DL7AD/pecanpico10/decoder/html/power.png

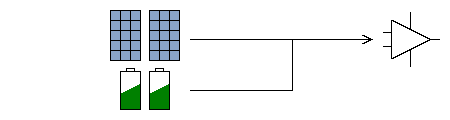
decoder/html/power.png
