DL7AD/pecanpico10/tracker/hardware/10a/output/pecanpico10_front.png

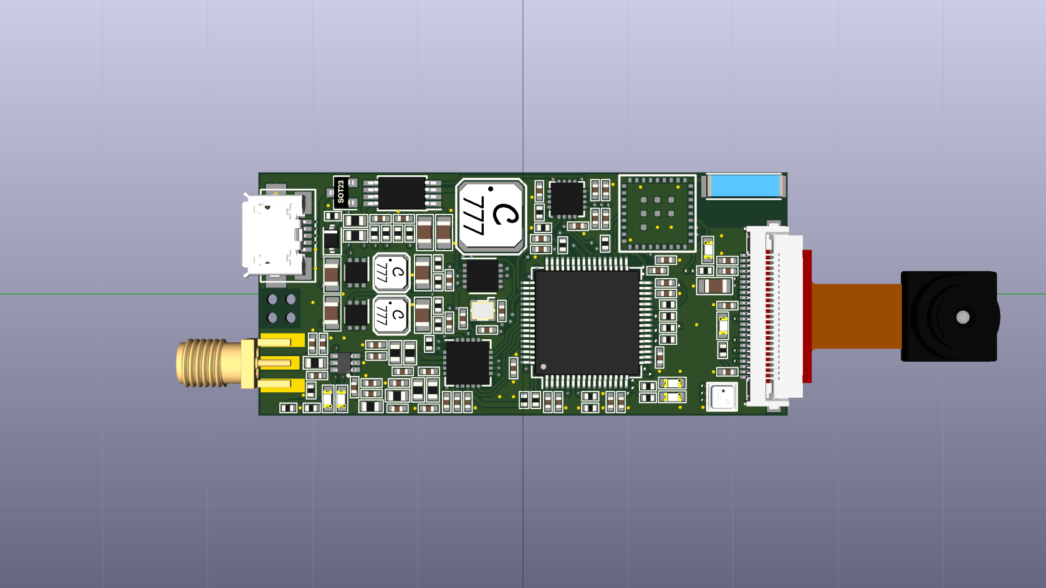
tracker/hardware/10a/output/pecanpico10_front.png
