DL7AD/pecanpico10/(threads)

Thread 3 (2018-08-04):

How to connect a camera?

df8oe, 2018-08-04:
I have bought OV5640 camera module whichuses 24p flatribbon connector. This seems to be a "standard" connector - many other camera modules do have this, too. But pinout is complete different to fpc used on Pecanpico... you can look for examples here:
[camera modules](https://www.alibaba.com/showroom/24-pin-hd-mini-camera-module.html)

Please can you point me how to adapt these modules to Pecanpico?

73
DF8OE
Andreas

Closed 2018-08-13.

Thread 5 (2018-11-06):

pecanpico10

SwiftFlying, 2018-11-06:
Hi,
PECANPICO10, will there be any image transmission error?

DL7AD, 2018-11-07:
Hi,

If you try to transmit an image without a camera attached to the Pecan itself, it will transmit an error picture instead.

Sven

SwiftFlying, 2018-11-07:
Hi,
https://github.com/TomasTT7/LoRa_SSDV
I'm testing LoRa_SSDV, Images transmitted are prone to errors. The author says there's something wrong with the camera power.I'm trying to solve this problem.And plans to build a relay device.

Tom

DL7AD, 2018-11-07:
Hi,

I have to admit that the SSDV algorithm is slightly modified from the original one because a APRS packet can't handle such long packets and overall also no binary data. The SyncByte, FEC and CRC is also not transmitted in the APRS packet because there is no need for it inside the APRS packet.

I shorten the SSDV packet by adding a new type
`#define SSDV_PKT_SIZE_PADDING (0x48)`

That option prevents the SSDV algorithm by putting so many bytes the packet. The additional data is simply put in the next packet. If you try to decode it with the very original SSDV code, you get an offset of the data.

While APRS can't handle binary data, we encode everything in base91 on top of it.

Sven

Closed 2019-02-05.
