DL7AD/pecanpico10/tracker/hardware/10b/output/pecanpico10.pdf

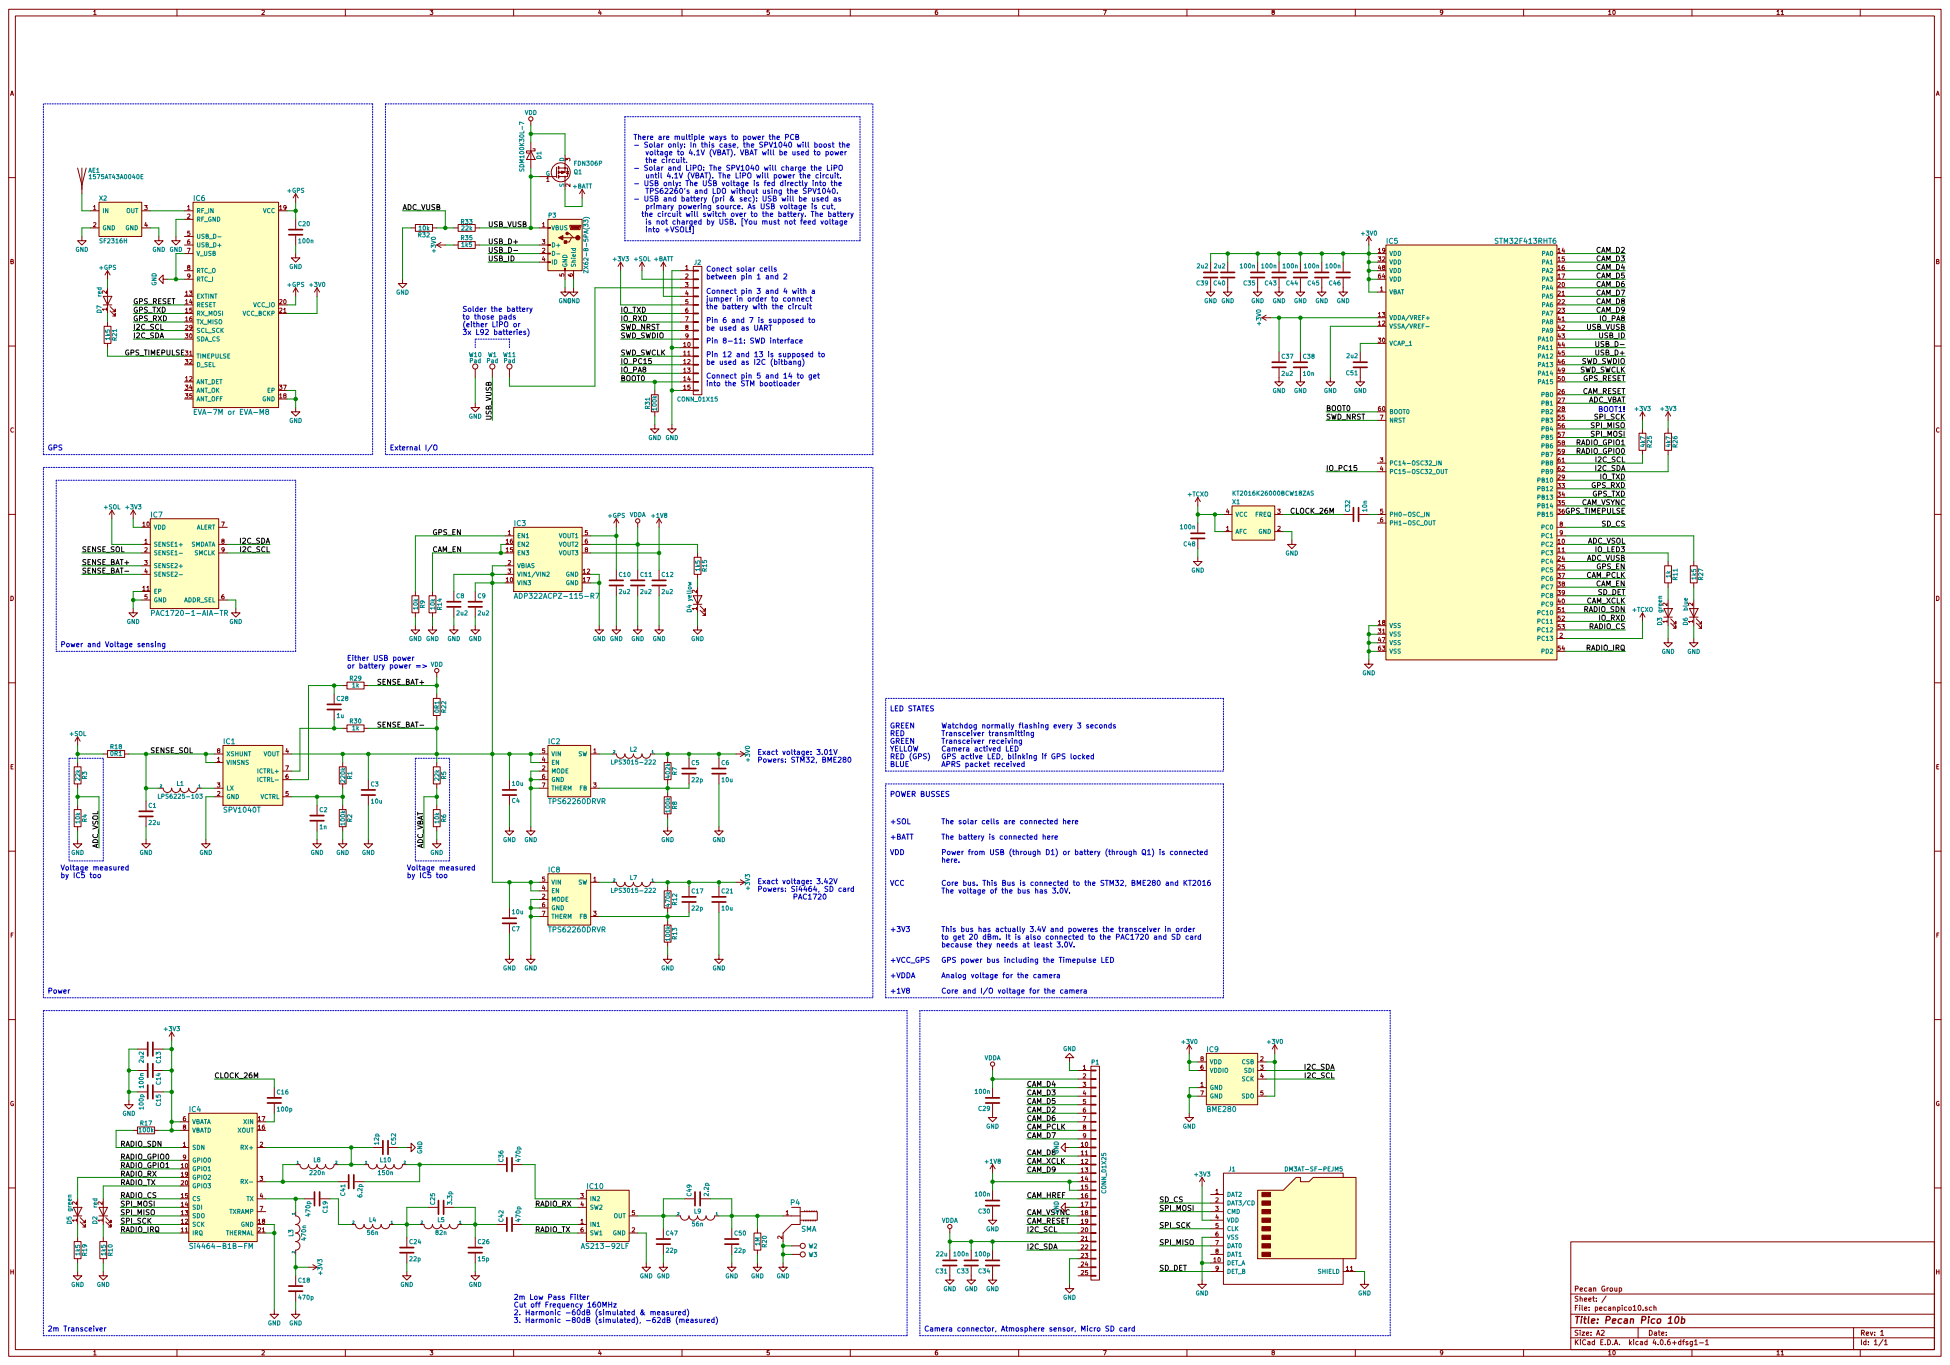
[picture p26: page 1]

There are multiple ways to power the PCB
- Solar only: In this case, the SPV1040 will boost the
voltage to 4.1V (VBAT). VBAT will be used to power
the circuit. - Solar and LiPO: The SPV1040 will charge the LiPO
until 4.1V (VBAT). The LiPO will power the circuit.
- USB only: The USB voltage is fed directly into the
TPS62260's and LDO without using the SPV1040.
- USB and battery (pri & sec): USB will be used as
primary powering source. As USB voltage is cut,
the circuit will switch over to the battery. The battery
is not charged by USB. [You must not feed voltage

+BATT Solder the battery

Conect solar cells
between pin 1 and 2
Connect pin 3 and 4 with a
jumper in order to connect
the battery with the circuit
Pin 6 and 7 is supposed to
be used as UART Pin 8-11: SWD interface
Pin 12 and 13 is supposed to
be used as I2C (bitbang)
Connect pin 5 and 14 to get
into the STM bootloader

Power and Voltage sensing

Transceiver transmitting
Transceiver receiving
Camera actived LED
GPS active LED, blinking if GPS locked
APRS packet received

Power from USB (through D1) or battery (through Q1) is connected
here. Core bus. This Bus is connected to the STM32, BME280 and KT2016

The voltage of the bus has 3.0V.

This bus has actually 3.4V and poweres the transceiver in order
to get 20 dBm. It is also connected to the PAC1720 and SD card
because they needs at least 3.0V.
GPS power bus including the Timepulse LED
Analog voltage for the camera
Core and I/O voltage for the camera
19 P1 CONN_01X25 GND GND GND

File: pecanpico10.sch Sheet: / Pecan Group

2m Low Pass Filter Cut off Frequency 160MHz
2. Harmonic -60dB (simulated & measured)
3. Harmonic -80dB (simulated), -62dB (measured)

Id: 1/1 Title: Pecan Pico 10b
