DL7AD/pecanpico10/tracker/hardware/10a/output/pecanpico10.pdf

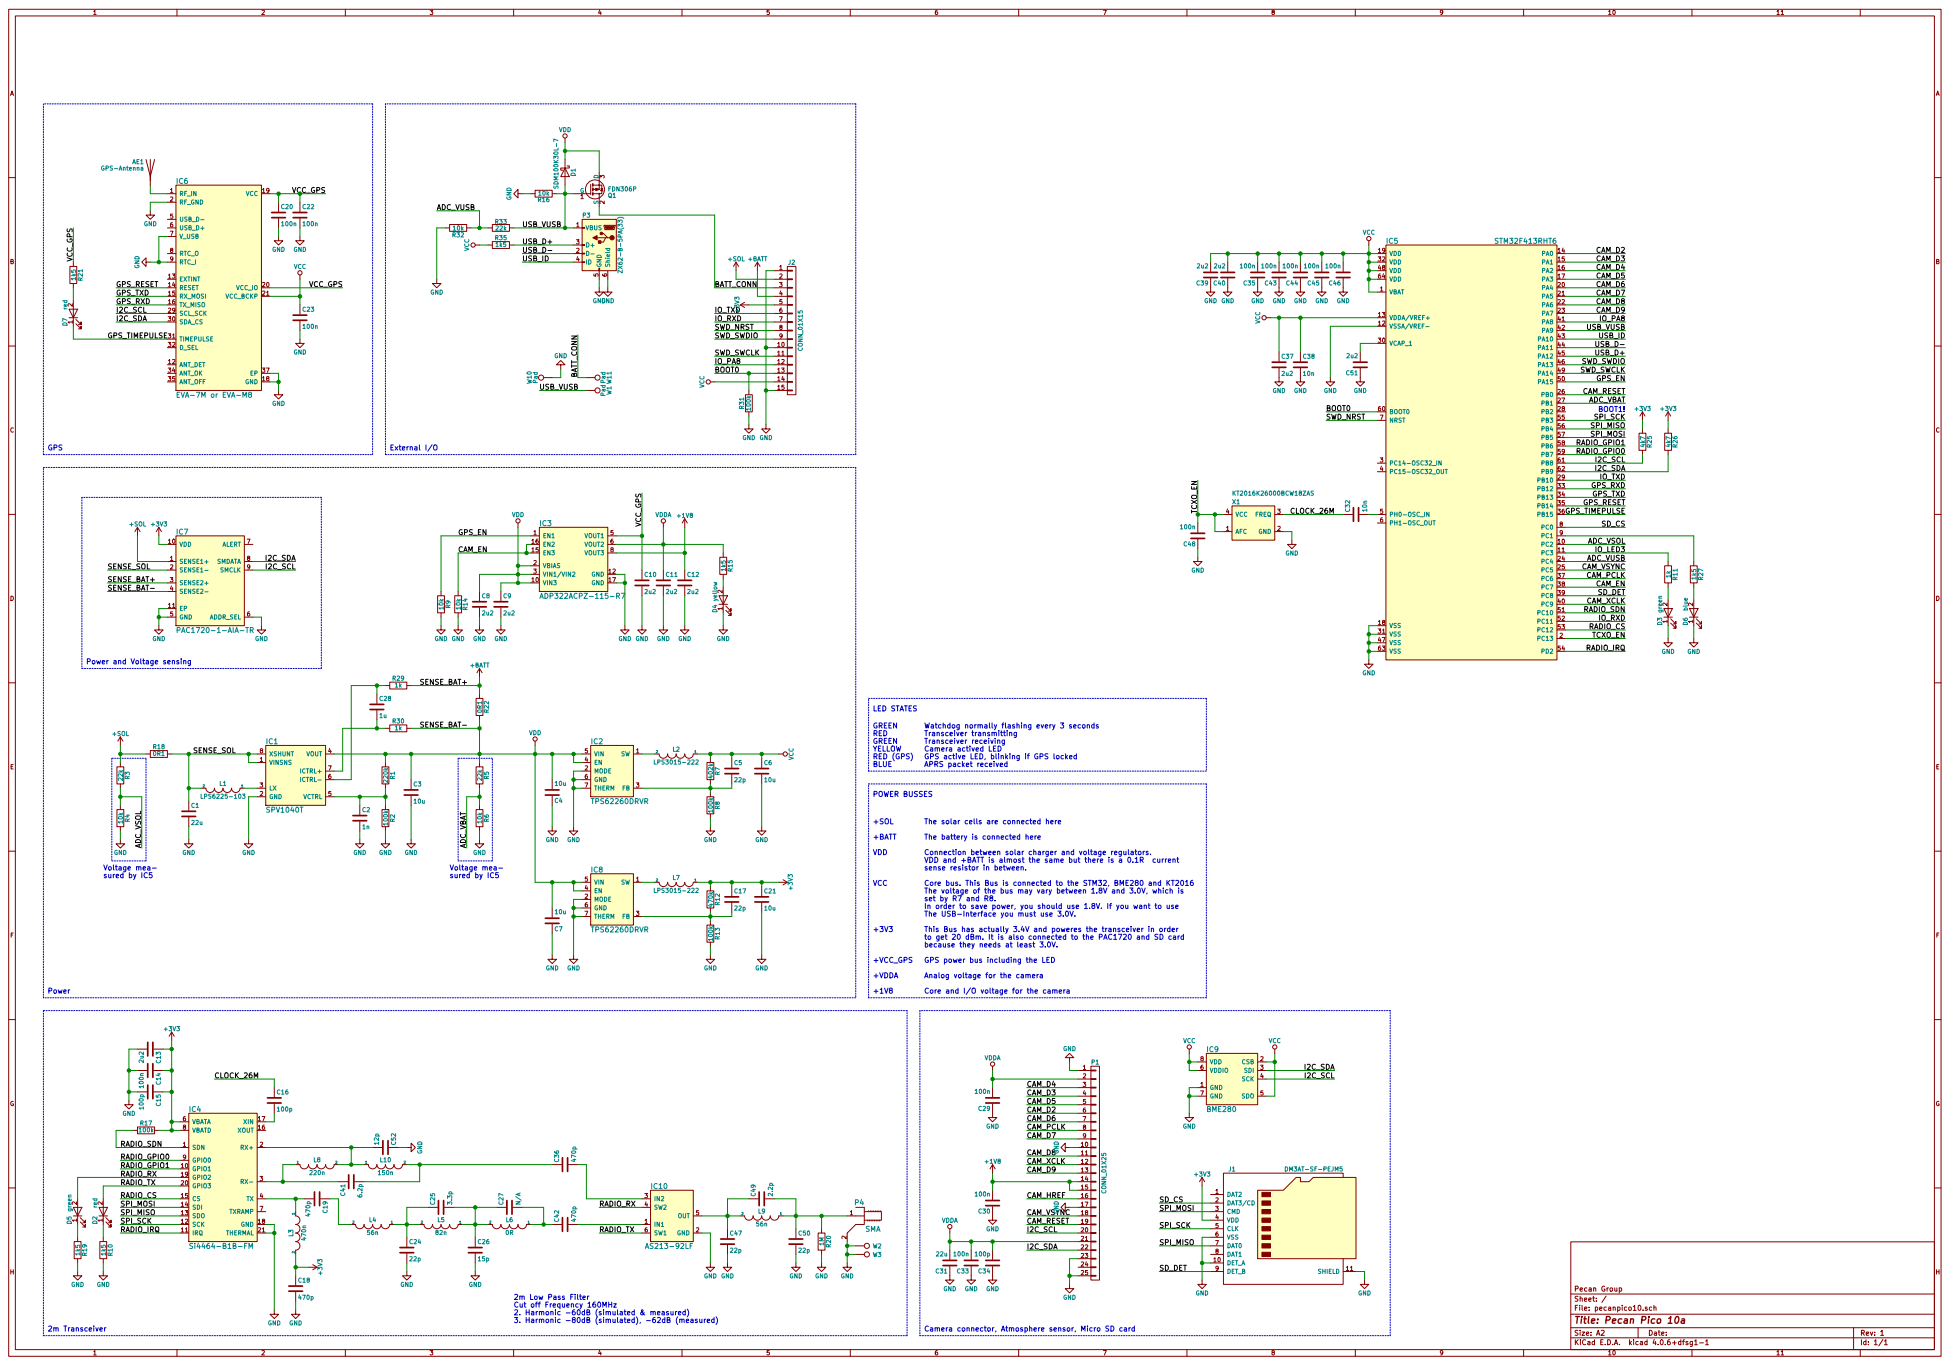
[picture p27: page 1]

27 PC6 | I2C_SCL

SPI_MISO
SPI_MOSI
RADIO_GPIO1

Power and Voltage sensing

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

Connection between solar charger and voltage regulators. VDD and +BATT is almost the same but there is a 0.1R current sense resistor in between. Core bus. This Bus is connected to the STM32, BME280 and KT2016

The voltage of the bus may vary between 1.8V and 3.0V, which is
set by R7 and R8.
In order to save power, you should use 1.8V. If you want to use
The USB-Interface you must use 3.0V.
This Bus has actually 3.4V and poweres the transceiver in order
to get 20 dBm. It is also connected to the PAC1720 and SD card
because they needs at least 3.0V.
GPS power bus including the LED
Analog voltage for the camera
Core and I/O voltage for the camera
19 P1 CONN_01X25 GND GND GND

File: pecanpico10.sch Sheet: / Pecan Group

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

Id: 1/1 Title: Pecan Pico 10a
