DL7AD/pecanpico10/tracker/hardware/10b/pecanpico10.kicad_pcb

## KiCad design tracker/hardware/10b/pecanpico10.kicad_pcb (2018-05-13)

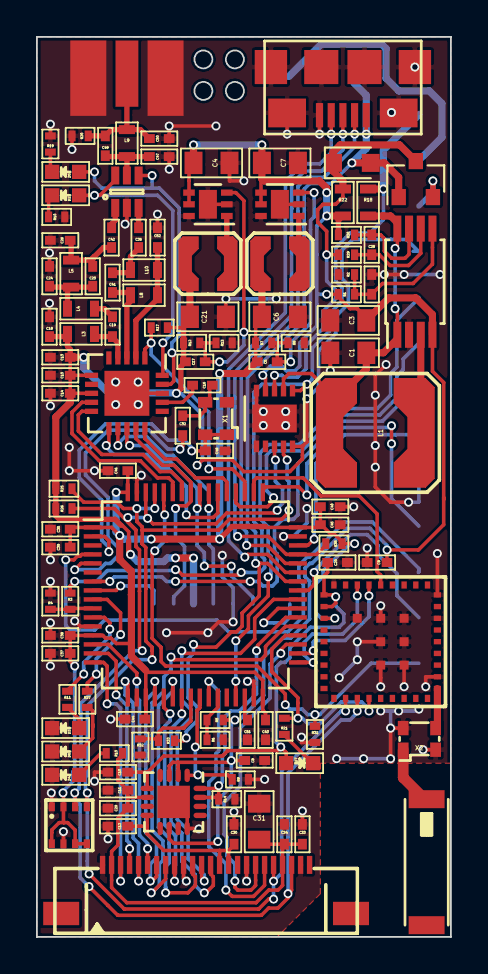
[picture p28: board pecanpico10.kicad_pcb from above]

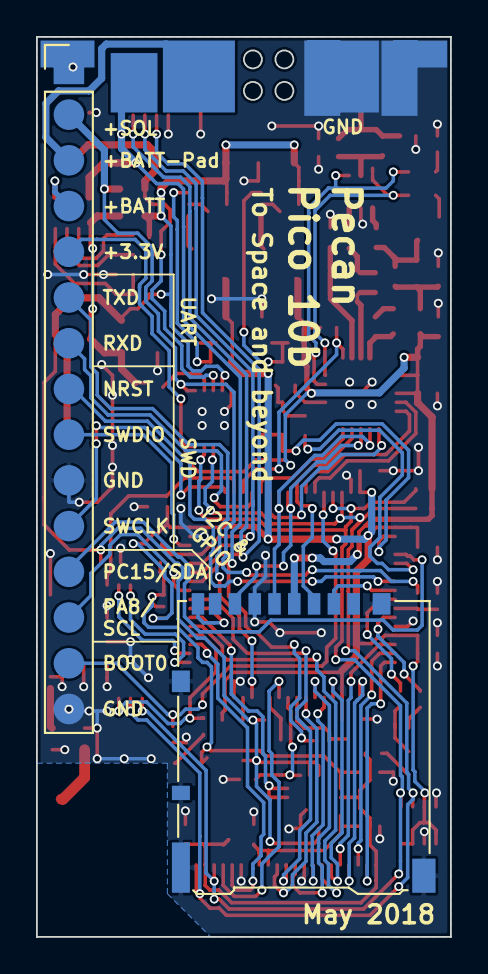
[picture p29: board pecanpico10.kicad_pcb from below]

Board: 2 copper layers, 23.0 x 50.0 mm, 119 parts (7 on the bottom side), 93 nets.

Parts:
AE1: 1575AT43A0040E; 575AT43A40
C1, C31: 22u; C_0805
C2: 1n; C_0402
C3, C4, C6, C7, C21: 10u; C_0805
C5, C17, C24, C47, C50: 22p; C_0402
C8, C9, C10, C11, C12, C13, C37, C39, C40, C51: 2u2; C_0402
C14, C20, C29, C30, C33, C35, C43, C44, C45, C46, C48: 100n; C_0402
C15, C16, C34: 100p; C_0402
C18, C19, C36, C42: 470p; C_0402
C25: 3.3p; C_0402
C26: 15p; C_0402
C28: 1u; C_0402
C32, C38: 10n; C_0402
C41: 6.2p; C_0402
C49: 2.2p; C_0402
C52: 12p; C_0402
D1: SDM100K30L-7; D_SOD-323
D2, D7: red; LED_0603
D3, D5: green; LED_0603
D4: yellow; LED_0603
D6: blue; LED_0603
IC1: SPV1040T; TSSOP-8_4.4x3mm_Pitch0.65mm
IC2, IC8: TPS62260DRVR; DFN-6-1EP_2x2mm_Pitch0.65mm
IC3: ADP322ACPZ-115-R7; QFN-16-1EP_3x3mm_Pitch0.5mm
IC4: Si4464-B1B-FM; QFN-20-1EP_4x4mm_Pitch0.5mm
IC5: STM32F413RHT6; LQFP-64_10x10mm_Pitch0.5mm
IC6: EVA-7M or EVA-M8; EVA7M
IC7: PAC1720-1-AIA-TR; DFN-10-1EP_3x3mm_Pitch0.5mm
IC9: BME280
IC10: AS213-92LF; SC-70-6
J1: DM3AT-SF-PEJM5; Hirose_DM3AT-SF-PEJM5
J2: CONN_01X15; Pin_Header_Straight_1x15_Pitch2.54mm
L1: LPS6225-103; LPS6225
L2, L7: LPS3015-222; LPS3015
L3: 470n; R_0603
L4, L9: 56n; R_0603
L5: 82n; R_0603
L8: 220n; R_0603
L10: 150n; R_0603
P1: CONN_01X25; FFC1x24_0.5mm
P3: ZX62-B-5PA(33); USB_Micro-B_SMD
P4: SMA; SMA_EDGE
Q1: FDN306P; SOT-23
R1: 220k; R_0402
R2, R8, R13, R17, R31: 100k; R_0402
R3, R5, R33: 22k; R_0402
R4, R6, R9, R14, R32: 10k; R_0402
R7: 402k; R_0402
R10, R15, R19, R21, R27, R35: 1k5; R_0402
R11, R29, R30: 1k; R_0402
R12: 470k; R_0402
R18, R22: 0R1; R_0603
R20: 1M; R_0402
R25, R26: 4k7; R_0402
W1, W11: Pad; PAD_3x3
W2, W3: Testpad; PAD_3x1.5
W10: Pad; PAD_6x3
X1: KT2016K26000BCW18ZAS; tcxo
X2: SF2316H; tcxo

Connections:
+1V8: C12.1, C30.2, IC3.8, P1.14, P1.15
+3V0: C5.1, C6.1, C35.2, C37.1, C38.1, C39.2, C40.2, C43.2, C44.2, C45.2, C46.2, IC5.1, IC5.13, IC5.19, IC5.32, IC5.48, IC5.64, IC6.21, IC9.2, IC9.5, IC9.6, IC9.8, L2.1, R7.1, R35.1
+3V3: C13.1, C14.1, C15.1, C17.1, C18.1, C21.1, IC4.6, IC4.8, IC7.10, J1.4, J2.5, L3.2, L7.1, R12.1, R17.2, R25.1, R26.1
+BATT: J2.4, Q1.2
+GPS: C10.1, C20.1, D7.2, IC3.5, IC6.19, IC6.20
+SOL: IC7.1, J2.2, R3.1, R18.1
+TCXO: C48.2, IC5.2, X1.1, X1.4
/ADC_VBAT: IC5.27, R5.2, R6.1
/ADC_VSOL: IC5.10, R3.2, R4.1
/ADC_VUSB: IC5.24, R32.1, R33.2
/BOOT0: IC5.60, J2.14, R31.1
/CAM_D2: IC5.14, P1.6
/CAM_D3: IC5.15, P1.4
/CAM_D4: IC5.16, P1.3
/CAM_D5: IC5.17, P1.5
/CAM_D6: IC5.20, P1.7
/CAM_D7: IC5.21, P1.9
/CAM_D8: IC5.22, P1.11
/CAM_D9: IC5.23, P1.13
/CAM_EN: IC3.15, IC3.16, IC5.38, R14.1
/CAM_PCLK: IC5.37, P1.8
/CAM_RESET: IC5.26, P1.19
/CAM_VSYNC: IC5.35, P1.18
/CAM_XCLK: IC5.40, P1.12
/CLOCK_26M: C16.1, C32.1, X1.3
/GPS_EN: IC3.1, IC5.25, R9.1
/GPS_RESET: IC5.50, IC6.14
/GPS_RXD: IC5.33, IC6.16
/GPS_TIMEPULSE: IC5.36, IC6.31, R21.2
/GPS_TXD: IC5.34, IC6.15
/I2C_SCL: IC5.61, IC6.29, IC7.9, IC9.4, P1.20, R25.2
/I2C_SDA: IC5.62, IC6.30, IC7.8, IC9.3, P1.22, R26.2
/IO_LED3: IC5.11, R11.1
/IO_PA8: IC5.41, J2.13
/IO_PC15: IC5.4, J2.12
/IO_RXD: IC5.52, J2.7
/IO_TXD: IC5.29, J2.6
/RADIO_CS: IC4.15, IC5.53
/RADIO_GPIO0: IC4.9, IC5.59
/RADIO_GPIO1: IC4.10, IC5.58
/RADIO_IRQ: IC4.11, IC5.54
/RADIO_RX: D5.2, IC4.19, IC10.4
/RADIO_SDN: IC4.1, IC5.51, R17.1
/RADIO_TX: D2.2, IC4.20, IC10.6
/SD_CS: IC5.8, J1.2
/SD_DET: IC5.39, J1.9
/SENSE_BAT-: C3.1, C4.2, C7.2, C8.1, C9.1, IC1.4, IC2.4, IC2.5, IC3.2, IC3.3, IC3.10, IC7.4, IC8.4, IC8.5, R1.1, R5.1, R22.2, R30.2
/SENSE_SOL: C1.1, IC1.1, IC1.8, IC7.2, L1.2, R18.2
/SPI_MISO: IC4.13, IC5.56, J1.7
/SPI_MOSI: IC4.14, IC5.57, J1.3
/SPI_SCK: IC4.12, IC5.55, J1.5
/SWD_NRST: IC5.7, J2.8
/SWD_SWCLK: IC5.49, J2.11
/SWD_SWDIO: IC5.46, J2.9
/USB_D+: IC5.45, P3.3, R35.2
/USB_D-: IC5.44, P3.2
/USB_ID: IC5.43, P3.4
/USB_VUSB: D1.2, IC5.42, P3.1, Q1.1, R33.1, W1.1
GND: C1.2, C2.2, C3.2, C4.1, C6.2, C7.1, C8.2, C9.2, C10.2, C11.2, C12.2, C13.2, C14.2, C15.2, C18.2, C20.2, C21.2, C24.2, C26.2, C29.1, C30.1, C31.1, C33.1, C34.1, C35.1, C37.2, C38.2, C39.1, C40.1, C43.1, C44.1, C45.1, C46.1, C47.2, C48.1, C50.2, C51.1, C52.1, D3.1, D4.1, D6.1, IC1.2, IC2.2, IC2.6, IC2.7, IC3.12, IC3.17, IC4.18, IC4.21, IC5.12, IC5.18, IC5.31, IC5.47, IC5.63, IC6.2, IC6.7, IC6.9, IC6.18, IC6.37, IC7.5, IC7.6, IC7.11, IC8.2, IC8.6, IC8.7, IC9.1, IC9.7, IC10.2, J1.6, J1.10, J1.11, J2.1, J2.10, J2.15, P1.1, P1.10, P1.17, P1.23, P3.5, P3.6, P4.2, R2.2, R4.2, R6.2, R8.2, R9.2, R10.2, R13.2, R14.2, R19.2, R20.2, R31.2, R32.2, W2.1, W3.1, W10.1, X1.2, X2.2, X2.4
unnamed: AE1.1, X2.1
unnamed: C2.1, IC1.5, R1.2, R2.1
unnamed: C5.2, IC2.3, R7.2, R8.1
unnamed: C16.2, IC4.17
unnamed: C17.2, IC8.3, R12.2, R13.1
unnamed: C19.1, L4.2
unnamed: C19.2, IC4.4, L3.1
unnamed: C24.1, C25.1, L4.1, L5.2
unnamed: C25.2, C26.1, C42.1, L5.1
unnamed: C28.1, IC1.6, R29.1
unnamed: C28.2, IC1.7, R30.1
unnamed: C32.2, IC5.5
unnamed: C36.1, C41.2, L10.2
unnamed: C36.2, IC10.3
unnamed: C41.1, IC4.3, L8.1
unnamed: C42.2, IC10.1
unnamed: C47.1, C49.1, IC10.5, L9.2
unnamed: C49.2, C50.1, L9.1, P4.1, R20.1
unnamed: C51.2, IC5.30
unnamed: C52.2, IC4.2, L8.2, L10.1
unnamed: D2.1, R10.1
unnamed: D3.2, R11.2
unnamed: D4.2, R15.2
unnamed: D5.1, R19.1
unnamed: D6.2, R27.2
unnamed: D7.1, R21.1
unnamed: IC1.3, L1.1
unnamed: IC2.1, L2.2
unnamed: IC5.9, R27.1
unnamed: IC6.1, X2.3
unnamed: IC8.1, L7.2
unnamed: J2.3, W11.1
VDD: D1.1, IC7.3, Q1.3, R22.1, R29.2
VDDA: C11.1, C29.2, C31.2, C33.2, C34.2, IC3.6, P1.2, P1.21, R15.1
