DL7AD/pecanpico10/tracker/software/cfg/pp10a/board/board.h

/*
    ChibiOS - Copyright (C) 2006..2016 Giovanni Di Sirio

    Licensed under the Apache License, Version 2.0 (the "License");
    you may not use this file except in compliance with the License.
    You may obtain a copy of the License at

        http://www.apache.org/licenses/LICENSE-2.0

    Unless required by applicable law or agreed to in writing, software
    distributed under the License is distributed on an "AS IS" BASIS,
    WITHOUT WARRANTIES OR CONDITIONS OF ANY KIND, either express or implied.
    See the License for the specific language governing permissions and
    limitations under the License.
*/

#ifndef _BOARD_H_
#define _BOARD_H_

/*
 * Setup for Pecan Pico 10a board.
 */

/*
 * Board identifier.
 */
#define BOARD_PECANPICO10A
#define BOARD_NAME                  "Pecan Pico 10a"

/*
 * No LSE available
 */
#if !defined(STM32_LSECLK)
#define STM32_LSECLK                0U
#endif

#if !defined(STM32_HSECLK)
#define STM32_HSECLK                26000000U
#endif

/*
 * Board voltages
 * Required for performance limits calculation
 */
#define STM32_VDD                   180U

/*
 * MCU type as defined in the ST header
 */
#define STM32F413xx

/*
 * IO pins assignments.
 */
#define GPIOA_PIN0                  0U
#define GPIOA_PIN1                  1U
#define GPIOA_PIN2                  2U
#define GPIOA_PIN3                  3U
#define GPIOA_PIN4                  4U
#define GPIOA_PIN5                  5U
#define GPIOA_PIN6                  6U
#define GPIOA_PIN7                  7U
#define GPIOA_PIN8                  8U
#define GPIOA_USB_VBUS              9U
#define GPIOA_USB_ID                10U
#define GPIOA_USB_DM                11U
#define GPIOA_USB_DP                12U
#define GPIOA_SWDIO                 13U
#define GPIOA_SWCLK                 14U
#define GPIOA_PIN15                 15U

#define GPIOB_PIN0                  0U
#define GPIOB_PIN1                  1U
#define GPIOB_PIN2                  2U
#define GPIOB_PIN3                  3U
#define GPIOB_PIN4                  4U
#define GPIOB_PIN5                  5U
#define GPIOB_PIN6                  6U
#define GPIOB_PIN7                  7U
#define GPIOB_PIN8                  8U
#define GPIOB_PIN9                  9U
#define GPIOB_PIN10                 10U
#define GPIOB_PIN11                 11U
#define GPIOB_PIN12                 12U
#define GPIOB_PIN13                 13U
#define GPIOB_PIN14                 14U
#define GPIOB_PIN15                 15U

#define GPIOC_PIN0                  0U
#define GPIOC_PIN1                  1U
#define GPIOC_PIN2                  2U
#define GPIOC_PIN3                  3U
#define GPIOC_PIN4                  4U
#define GPIOC_PIN5                  5U
#define GPIOC_PIN6                  6U
#define GPIOC_PIN7                  7U
#define GPIOC_PIN8                  8U
#define GPIOC_PIN9                  9U
#define GPIOC_PIN10                 10U
#define GPIOC_PIN11                 11U
#define GPIOC_PIN12                 12U
#define GPIOC_PIN13                 13U
#define GPIOC_OSC32_IN              14U
#define GPIOC_OSC32_OUT             15U

#define GPIOD_PIN0                  0U
#define GPIOD_PIN1                  1U
#define GPIOD_PIN2                  2U
#define GPIOD_PIN3                  3U
#define GPIOD_PIN4                  4U
#define GPIOD_PIN5                  5U
#define GPIOD_PIN6                  6U
#define GPIOD_PIN7                  7U
#define GPIOD_PIN8                  8U
#define GPIOD_PIN9                  9U
#define GPIOD_PIN10                 10U
#define GPIOD_PIN11                 11U
#define GPIOD_PIN12                 12U
#define GPIOD_PIN13                 13U
#define GPIOD_PIN14                 14U
#define GPIOD_PIN15                 15U

#define GPIOE_PIN0                  0U
#define GPIOE_PIN1                  1U
#define GPIOE_PIN2                  2U
#define GPIOE_PIN3                  3U
#define GPIOE_PIN4                  4U
#define GPIOE_PIN5                  5U
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
#define GPIOJ_PIN9                  9U
#define GPIOJ_PIN10                 10U
#define GPIOJ_PIN11                 11U
#define GPIOJ_PIN12                 12U
#define GPIOJ_PIN13                 13U
#define GPIOJ_PIN14                 14U
#define GPIOJ_PIN15                 15U

#define GPIOK_PIN0                  0U
#define GPIOK_PIN1                  1U
#define GPIOK_PIN2                  2U
#define GPIOK_PIN3                  3U
#define GPIOK_PIN4                  4U
#define GPIOK_PIN5                  5U
#define GPIOK_PIN6                  6U
#define GPIOK_PIN7                  7U
#define GPIOK_PIN8                  8U
#define GPIOK_PIN9                  9U
#define GPIOK_PIN10                 10U
#define GPIOK_PIN11                 11U
#define GPIOK_PIN12                 12U
#define GPIOK_PIN13                 13U
#define GPIOK_PIN14                 14U
#define GPIOK_PIN15                 15U

/* For enabling TCXO. Done in early_init. */
#define LINE_TCXO_EN                PAL_LINE(GPIOC, 13U)

/*
 * I/O ports initial setup, this configuration is established soon after reset
 * in the initialization code.
 * Please refer to the STM32 Reference Manual for details.
 */
#define PIN_MODE_INPUT(n)           (0U << ((n) * 2U))
#define PIN_MODE_OUTPUT(n)          (1U << ((n) * 2U))
#define PIN_MODE_ALTERNATE(n)       (2U << ((n) * 2U))
#define PIN_MODE_ANALOG(n)          (3U << ((n) * 2U))
#define PIN_ODR_LOW(n)              (0U << (n))
#define PIN_ODR_HIGH(n)             (1U << (n))
#define PIN_OTYPE_PUSHPULL(n)       (0U << (n))
#define PIN_OTYPE_OPENDRAIN(n)      (1U << (n))
#define PIN_OSPEED_VERYLOW(n)       (0U << ((n) * 2U))
#define PIN_OSPEED_LOW(n)           (1U << ((n) * 2U))
#define PIN_OSPEED_MEDIUM(n)        (2U << ((n) * 2U))
#define PIN_OSPEED_HIGH(n)          (3U << ((n) * 2U))
#define PIN_PUPDR_FLOATING(n)       (0U << ((n) * 2U))
#define PIN_PUPDR_PULLUP(n)         (1U << ((n) * 2U))
#define PIN_PUPDR_PULLDOWN(n)       (2U << ((n) * 2U))
#define PIN_AFIO_AF(n, v)           ((v) << (((n) % 8U) * 4U))

/*
 * GPIOA setup:
 *
 * PA0  - CAM_D2                    (input pulldown).
 * PA1  - CAM_D3                    (input pulldown).
 * PA2  - CAM_D4                    (input pulldown).
 * PA3  - CAM_D5                    (input pulldown).
 * PA4  - CAM_D6                    (input pulldown).
 * PA5  - CAM_D7                    (input pulldown).
 * PA6  - CAM_D8                    (input pulldown).
 * PA7  - CAM_D9                    (input pulldown).
 * PA8  - IO_PA8                    (input floating).
 * PA9  - USB_VBUS                  (input floating).
 * PA10 - USB_ID                    (alternate 10).
 * PA11 - USB_DM                    (alternate 10).
 * PA12 - USB_DP                    (alternate 10).
 * PA13 - SWDIO                     (alternate 0).
 * PA14 - SWCLK                     (alternate 0).
 * PA15 - GPS_EN                    (input pulldown).
 */
#define VAL_GPIOA_MODER             (PIN_MODE_INPUT(GPIOA_PIN0) |           \
                                     PIN_MODE_INPUT(GPIOA_PIN1) |           \
                                     PIN_MODE_INPUT(GPIOA_PIN2) |           \
                                     PIN_MODE_INPUT(GPIOA_PIN3) |           \
                                     PIN_MODE_INPUT(GPIOA_PIN4) |           \
                                     PIN_MODE_INPUT(GPIOA_PIN5) |           \
                                     PIN_MODE_INPUT(GPIOA_PIN6) |           \
                                     PIN_MODE_INPUT(GPIOA_PIN7) |           \
                                     PIN_MODE_INPUT(GPIOA_PIN8) |           \
                                     PIN_MODE_INPUT(GPIOA_USB_VBUS) |       \
                                     PIN_MODE_ALTERNATE(GPIOA_USB_ID) |     \
                                     PIN_MODE_ALTERNATE(GPIOA_USB_DM) |     \
                                     PIN_MODE_ALTERNATE(GPIOA_USB_DP) |     \
                                     PIN_MODE_ALTERNATE(GPIOA_SWDIO) |      \
                                     PIN_MODE_ALTERNATE(GPIOA_SWCLK) |      \
                                     PIN_MODE_INPUT(GPIOA_PIN15))
#define VAL_GPIOA_OTYPER            (PIN_OTYPE_PUSHPULL(GPIOA_PIN0) |       \
                                     PIN_OTYPE_PUSHPULL(GPIOA_PIN1) |       \
                                     PIN_OTYPE_PUSHPULL(GPIOA_PIN2) |       \
                                     PIN_OTYPE_PUSHPULL(GPIOA_PIN3) |       \
                                     PIN_OTYPE_PUSHPULL(GPIOA_PIN4) |       \
                                     PIN_OTYPE_PUSHPULL(GPIOA_PIN5) |       \
                                     PIN_OTYPE_PUSHPULL(GPIOA_PIN6) |       \
                                     PIN_OTYPE_PUSHPULL(GPIOA_PIN7) |       \
                                     PIN_OTYPE_PUSHPULL(GPIOA_PIN8) |       \
                                     PIN_OTYPE_PUSHPULL(GPIOA_USB_VBUS) |   \
                                     PIN_OTYPE_PUSHPULL(GPIOA_USB_ID) |     \
                                     PIN_OTYPE_PUSHPULL(GPIOA_USB_DM) |     \
                                     PIN_OTYPE_PUSHPULL(GPIOA_USB_DP) |     \
                                     PIN_OTYPE_PUSHPULL(GPIOA_SWDIO) |      \
                                     PIN_OTYPE_PUSHPULL(GPIOA_SWCLK) |      \
                                     PIN_OTYPE_PUSHPULL(GPIOA_PIN15))
#define VAL_GPIOA_OSPEEDR           (PIN_OSPEED_VERYLOW(GPIOA_PIN0) |       \
                                     PIN_OSPEED_VERYLOW(GPIOA_PIN1) |       \
                                     PIN_OSPEED_VERYLOW(GPIOA_PIN2) |       \
                                     PIN_OSPEED_VERYLOW(GPIOA_PIN3) |       \
                                     PIN_OSPEED_VERYLOW(GPIOA_PIN4) |       \
                                     PIN_OSPEED_VERYLOW(GPIOA_PIN5) |       \
                                     PIN_OSPEED_VERYLOW(GPIOA_PIN6) |       \
                                     PIN_OSPEED_VERYLOW(GPIOA_PIN7) |       \
                                     PIN_OSPEED_VERYLOW(GPIOA_PIN8) |       \
                                     PIN_OSPEED_HIGH(GPIOA_USB_VBUS) |      \
                                     PIN_OSPEED_HIGH(GPIOA_USB_ID) |        \
                                     PIN_OSPEED_HIGH(GPIOA_USB_DM) |        \
                                     PIN_OSPEED_HIGH(GPIOA_USB_DP) |        \
                                     PIN_OSPEED_HIGH(GPIOA_SWDIO) |         \
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
                                     PIN_AFIO_AF(GPIOA_SWDIO, 0) |          \
                                     PIN_AFIO_AF(GPIOA_SWCLK, 0) |          \
                                     PIN_AFIO_AF(GPIOA_PIN15, 0))

/*
 * GPIOB setup:
 *
 * PB0  - CAM_RESET                 (input pulldown).
 * PB1  - ADC_VBAT                  (input pulldown).
 * PB2  - BOOT1                     (input pulldown).
 * PB3  - SPI_SCK                   (input pulldown).
 * PB4  - SPI_MISO                  (input pulldown).
 * PB5  - SPI_MOSI                  (input pulldown).
 * PB6  - RADIO_GPIO1               (input pulldown).
 * PB7  - RADIO_GPIO0               (input pulldown).
 * PB8  - I2C_SCL                   (input pulldown).
 * PB9  - I2C_SDA                   (input pulldown).
 * PB10 - IO_TXD                    (input floating).
 * PB11 - PIN11                     (input pulldown).
 * PB12 - GPS_RXD                   (input pulldown).
 * PB13 - GPS_TXD                   (input pulldown).
 * PB14 - GPS_RESET                 (input pulldown).
 * PB15 - GPS_TIMEPULSE             (input pulldown).
 */
#define VAL_GPIOB_MODER             (PIN_MODE_INPUT(GPIOB_PIN0) |           \
                                     PIN_MODE_INPUT(GPIOB_PIN1) |           \
                                     PIN_MODE_INPUT(GPIOB_PIN2) |           \
                                     PIN_MODE_INPUT(GPIOB_PIN3) |           \
                                     PIN_MODE_INPUT(GPIOB_PIN4) |           \
                                     PIN_MODE_INPUT(GPIOB_PIN5) |           \
                                     PIN_MODE_INPUT(GPIOB_PIN6) |           \
                                     PIN_MODE_INPUT(GPIOB_PIN7) |           \
                                     PIN_MODE_INPUT(GPIOB_PIN8) |           \
                                     PIN_MODE_INPUT(GPIOB_PIN9) |           \
                                     PIN_MODE_INPUT(GPIOB_PIN10) |          \
                                     PIN_MODE_INPUT(GPIOB_PIN11) |          \
                                     PIN_MODE_INPUT(GPIOB_PIN12) |          \
                                     PIN_MODE_INPUT(GPIOB_PIN13) |          \
                                     PIN_MODE_INPUT(GPIOB_PIN14) |          \
                                     PIN_MODE_INPUT(GPIOB_PIN15))
#define VAL_GPIOB_OTYPER            (PIN_OTYPE_PUSHPULL(GPIOB_PIN0) |       \
                                     PIN_OTYPE_PUSHPULL(GPIOB_PIN1) |       \
                                     PIN_OTYPE_PUSHPULL(GPIOB_PIN2) |       \
                                     PIN_OTYPE_PUSHPULL(GPIOB_PIN3) |       \
                                     PIN_OTYPE_PUSHPULL(GPIOB_PIN4) |       \
                                     PIN_OTYPE_PUSHPULL(GPIOB_PIN5) |       \
                                     PIN_OTYPE_PUSHPULL(GPIOB_PIN6) |       \
                                     PIN_OTYPE_PUSHPULL(GPIOB_PIN7) |       \
                                     PIN_OTYPE_PUSHPULL(GPIOB_PIN8) |       \
                                     PIN_OTYPE_PUSHPULL(GPIOB_PIN9) |       \
                                     PIN_OTYPE_PUSHPULL(GPIOB_PIN10) |      \
                                     PIN_OTYPE_PUSHPULL(GPIOB_PIN11) |      \
                                     PIN_OTYPE_PUSHPULL(GPIOB_PIN12) |      \
                                     PIN_OTYPE_PUSHPULL(GPIOB_PIN13) |      \
                                     PIN_OTYPE_PUSHPULL(GPIOB_PIN14) |      \
                                     PIN_OTYPE_PUSHPULL(GPIOB_PIN15))
#define VAL_GPIOB_OSPEEDR           (PIN_OSPEED_VERYLOW(GPIOB_PIN0) |       \
                                     PIN_OSPEED_VERYLOW(GPIOB_PIN1) |       \
                                     PIN_OSPEED_VERYLOW(GPIOB_PIN2) |       \
                                     PIN_OSPEED_HIGH(GPIOB_PIN3) |          \
                                     PIN_OSPEED_HIGH(GPIOB_PIN4) |          \
                                     PIN_OSPEED_HIGH(GPIOB_PIN5) |          \
                                     PIN_OSPEED_VERYLOW(GPIOB_PIN6) |       \
                                     PIN_OSPEED_VERYLOW(GPIOB_PIN7) |       \
                                     PIN_OSPEED_VERYLOW(GPIOB_PIN8) |       \
                                     PIN_OSPEED_VERYLOW(GPIOB_PIN9) |       \
                                     PIN_OSPEED_VERYLOW(GPIOB_PIN10) |      \
                                     PIN_OSPEED_VERYLOW(GPIOB_PIN11) |      \
                                     PIN_OSPEED_VERYLOW(GPIOB_PIN12) |      \
                                     PIN_OSPEED_VERYLOW(GPIOB_PIN13) |      \
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
                                     PIN_AFIO_AF(GPIOB_PIN13, 0) |          \
                                     PIN_AFIO_AF(GPIOB_PIN14, 0) |          \
                                     PIN_AFIO_AF(GPIOB_PIN15, 0))

/*
 * GPIOC setup:
 * TODO: Enter correct assignment (versus NUCLEO pins)
 * PC0  - SD_CS                     (output pushpull highspeed high).
 * PC1  - IO_BLUE                   (input pulldown).
 * PC2  - ADC_VSOL                  (input pulldown).
 * PC3  - IO_GREEN                  (input pulldown).
 * PC4  - ADC_VUSB                  (input pulldown).
 * PC5  - CAM_VSYNC                 (input pulldown).
 * PC6  - CAM_PCLK                  (input pulldown).
 * PC7  - CAM_EN                    (input pulldown).
 * PC8  - SD_DET                    (input pullup verylowspeed).
 * PC9  - CAM_XCLK                  (input pulldown).
 * PC10 - RADIO_SDN                 (output opendrain pullup high verylowspeed).
 * PC11 - IO_RXD                    (input floating).
 * PC12 - RADIO_CS                  (output pushpull high).
 * PC13 - TCXO_EN                   (input pulldown).
 * PC14 - OSC32_IN                  (input floating).
 * PC15 - OSC32_OUT                 (input floating).
 */
#define VAL_GPIOC_MODER             (PIN_MODE_OUTPUT(GPIOC_PIN0) |          \
                                     PIN_MODE_INPUT(GPIOC_PIN1) |           \
                                     PIN_MODE_INPUT(GPIOC_PIN2) |           \
                                     PIN_MODE_INPUT(GPIOC_PIN3) |           \
                                     PIN_MODE_INPUT(GPIOC_PIN4) |           \
                                     PIN_MODE_INPUT(GPIOC_PIN5) |           \
                                     PIN_MODE_INPUT(GPIOC_PIN6) |           \
                                     PIN_MODE_INPUT(GPIOC_PIN7) |           \
                                     PIN_MODE_INPUT(GPIOC_PIN8) |           \
                                     PIN_MODE_INPUT(GPIOC_PIN9) |           \
                                     PIN_MODE_OUTPUT(GPIOC_PIN10) |         \
                                     PIN_MODE_INPUT(GPIOC_PIN11) |          \
                                     PIN_MODE_OUTPUT(GPIOC_PIN12) |         \
                                     PIN_MODE_INPUT(GPIOC_PIN13) |          \
                                     PIN_MODE_INPUT(GPIOC_OSC32_IN) |       \
                                     PIN_MODE_INPUT(GPIOC_OSC32_OUT))
#define VAL_GPIOC_OTYPER            (PIN_OTYPE_PUSHPULL(GPIOC_PIN0) |       \
                                     PIN_OTYPE_PUSHPULL(GPIOC_PIN1) |       \
                                     PIN_OTYPE_PUSHPULL(GPIOC_PIN2) |       \
                                     PIN_OTYPE_PUSHPULL(GPIOC_PIN3) |       \
                                     PIN_OTYPE_PUSHPULL(GPIOC_PIN4) |       \
                                     PIN_OTYPE_PUSHPULL(GPIOC_PIN5) |       \
                                     PIN_OTYPE_PUSHPULL(GPIOC_PIN6) |       \
                                     PIN_OTYPE_PUSHPULL(GPIOC_PIN7) |       \
                                     PIN_OTYPE_PUSHPULL(GPIOC_PIN8) |       \
                                     PIN_OTYPE_PUSHPULL(GPIOC_PIN9) |       \
                                     PIN_OTYPE_OPENDRAIN(GPIOC_PIN10) |     \
                                     PIN_OTYPE_PUSHPULL(GPIOC_PIN11) |      \
                                     PIN_OTYPE_PUSHPULL(GPIOC_PIN12) |      \
                                     PIN_OTYPE_PUSHPULL(GPIOC_PIN13) |      \
                                     PIN_OTYPE_PUSHPULL(GPIOC_OSC32_IN) |   \
                                     PIN_OTYPE_PUSHPULL(GPIOC_OSC32_OUT))
#define VAL_GPIOC_OSPEEDR           (PIN_OSPEED_HIGH(GPIOC_PIN0) |          \
                                     PIN_OSPEED_VERYLOW(GPIOC_PIN1) |       \
                                     PIN_OSPEED_VERYLOW(GPIOC_PIN2) |       \
                                     PIN_OSPEED_VERYLOW(GPIOC_PIN3) |       \
                                     PIN_OSPEED_VERYLOW(GPIOC_PIN4) |       \
                                     PIN_OSPEED_VERYLOW(GPIOC_PIN5) |       \
                                     PIN_OSPEED_VERYLOW(GPIOC_PIN6) |       \
                                     PIN_OSPEED_VERYLOW(GPIOC_PIN7) |       \
                                     PIN_OSPEED_VERYLOW(GPIOC_PIN8) |       \
                                     PIN_OSPEED_VERYLOW(GPIOC_PIN9) |       \
                                     PIN_OSPEED_VERYLOW(GPIOC_PIN10) |      \
                                     PIN_OSPEED_VERYLOW(GPIOC_PIN11) |      \
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
                                     PIN_AFIO_AF(GPIOG_PIN13, 0) |          \
                                     PIN_AFIO_AF(GPIOG_PIN14, 0) |          \
                                     PIN_AFIO_AF(GPIOG_PIN15, 0))

/*
 * GPIOH setup:
 *
 * PH0  - OSC_IN                    (input floating).
 * PH1  - OSC_OUT                   (input floating).
 * PH2  - PIN2                      (input pulldown).
 * PH3  - PIN3                      (input pulldown).
 * PH4  - PIN4                      (input pulldown).
 * PH5  - PIN5                      (input pulldown).
 * PH6  - PIN6                      (input pulldown).
 * PH7  - PIN7                      (input pulldown).
 * PH8  - PIN8                      (input pulldown).
 * PH9  - PIN9                      (input pulldown).
 * PH10 - PIN10                     (input pulldown).
 * PH11 - PIN11                     (input pulldown).
 * PH12 - PIN12                     (input pulldown).
 * PH13 - PIN13                     (input pulldown).
 * PH14 - PIN14                     (input pulldown).
 * PH15 - PIN15                     (input pulldown).
 */
#define VAL_GPIOH_MODER             (PIN_MODE_INPUT(GPIOH_OSC_IN) |         \
                                     PIN_MODE_INPUT(GPIOH_OSC_OUT) |        \
                                     PIN_MODE_INPUT(GPIOH_PIN2) |           \
                                     PIN_MODE_INPUT(GPIOH_PIN3) |           \
                                     PIN_MODE_INPUT(GPIOH_PIN4) |           \
                                     PIN_MODE_INPUT(GPIOH_PIN5) |           \
                                     PIN_MODE_INPUT(GPIOH_PIN6) |           \
                                     PIN_MODE_INPUT(GPIOH_PIN7) |           \
                                     PIN_MODE_INPUT(GPIOH_PIN8) |           \
                                     PIN_MODE_INPUT(GPIOH_PIN9) |           \
                                     PIN_MODE_INPUT(GPIOH_PIN10) |          \
                                     PIN_MODE_INPUT(GPIOH_PIN11) |          \
                                     PIN_MODE_INPUT(GPIOH_PIN12) |          \
                                     PIN_MODE_INPUT(GPIOH_PIN13) |          \
                                     PIN_MODE_INPUT(GPIOH_PIN14) |          \
                                     PIN_MODE_INPUT(GPIOH_PIN15))
#define VAL_GPIOH_OTYPER            (PIN_OTYPE_PUSHPULL(GPIOH_OSC_IN) |     \
                                     PIN_OTYPE_PUSHPULL(GPIOH_OSC_OUT) |    \
                                     PIN_OTYPE_PUSHPULL(GPIOH_PIN2) |       \
                                     PIN_OTYPE_PUSHPULL(GPIOH_PIN3) |       \
                                     PIN_OTYPE_PUSHPULL(GPIOH_PIN4) |       \
                                     PIN_OTYPE_PUSHPULL(GPIOH_PIN5) |       \
                                     PIN_OTYPE_PUSHPULL(GPIOH_PIN6) |       \
                                     PIN_OTYPE_PUSHPULL(GPIOH_PIN7) |       \
                                     PIN_OTYPE_PUSHPULL(GPIOH_PIN8) |       \
                                     PIN_OTYPE_PUSHPULL(GPIOH_PIN9) |       \
                                     PIN_OTYPE_PUSHPULL(GPIOH_PIN10) |      \
                                     PIN_OTYPE_PUSHPULL(GPIOH_PIN11) |      \
                                     PIN_OTYPE_PUSHPULL(GPIOH_PIN12) |      \
                                     PIN_OTYPE_PUSHPULL(GPIOH_PIN13) |      \
                                     PIN_OTYPE_PUSHPULL(GPIOH_PIN14) |      \
                                     PIN_OTYPE_PUSHPULL(GPIOH_PIN15))
#define VAL_GPIOH_OSPEEDR           (PIN_OSPEED_HIGH(GPIOH_OSC_IN) |        \
                                     PIN_OSPEED_HIGH(GPIOH_OSC_OUT) |       \
                                     PIN_OSPEED_VERYLOW(GPIOH_PIN2) |       \
                                     PIN_OSPEED_VERYLOW(GPIOH_PIN3) |       \
                                     PIN_OSPEED_VERYLOW(GPIOH_PIN4) |       \
                                     PIN_OSPEED_VERYLOW(GPIOH_PIN5) |       \
                                     PIN_OSPEED_VERYLOW(GPIOH_PIN6) |       \
                                     PIN_OSPEED_VERYLOW(GPIOH_PIN7) |       \
                                     PIN_OSPEED_VERYLOW(GPIOH_PIN8) |       \
                                     PIN_OSPEED_VERYLOW(GPIOH_PIN9) |       \
                                     PIN_OSPEED_VERYLOW(GPIOH_PIN10) |      \
                                     PIN_OSPEED_VERYLOW(GPIOH_PIN11) |      \
                                     PIN_OSPEED_VERYLOW(GPIOH_PIN12) |      \
                                     PIN_OSPEED_VERYLOW(GPIOH_PIN13) |      \
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
                                     PIN_PUPDR_PULLDOWN(GPIOK_PIN14) |      \
                                     PIN_PUPDR_PULLDOWN(GPIOK_PIN15))
#define VAL_GPIOK_ODR               (PIN_ODR_HIGH(GPIOK_PIN0) |             \
                                     PIN_ODR_HIGH(GPIOK_PIN1) |             \
                                     PIN_ODR_HIGH(GPIOK_PIN2) |             \
                                     PIN_ODR_HIGH(GPIOK_PIN3) |             \
                                     PIN_ODR_HIGH(GPIOK_PIN4) |             \
                                     PIN_ODR_HIGH(GPIOK_PIN5) |             \
                                     PIN_ODR_HIGH(GPIOK_PIN6) |             \
                                     PIN_ODR_HIGH(GPIOK_PIN7) |             \
                                     PIN_ODR_HIGH(GPIOK_PIN8) |             \
                                     PIN_ODR_HIGH(GPIOK_PIN9) |             \
                                     PIN_ODR_HIGH(GPIOK_PIN10) |            \
                                     PIN_ODR_HIGH(GPIOK_PIN11) |            \
                                     PIN_ODR_HIGH(GPIOK_PIN12) |            \
                                     PIN_ODR_HIGH(GPIOK_PIN13) |            \
                                     PIN_ODR_HIGH(GPIOK_PIN14) |            \
                                     PIN_ODR_HIGH(GPIOK_PIN15))
#define VAL_GPIOK_AFRL              (PIN_AFIO_AF(GPIOK_PIN0, 0) |           \
                                     PIN_AFIO_AF(GPIOK_PIN1, 0) |           \
                                     PIN_AFIO_AF(GPIOK_PIN2, 0) |           \
                                     PIN_AFIO_AF(GPIOK_PIN3, 0) |           \
                                     PIN_AFIO_AF(GPIOK_PIN4, 0) |           \
                                     PIN_AFIO_AF(GPIOK_PIN5, 0) |           \
                                     PIN_AFIO_AF(GPIOK_PIN6, 0) |           \
                                     PIN_AFIO_AF(GPIOK_PIN7, 0))
#define VAL_GPIOK_AFRH              (PIN_AFIO_AF(GPIOK_PIN8, 0) |           \
                                     PIN_AFIO_AF(GPIOK_PIN9, 0) |           \
                                     PIN_AFIO_AF(GPIOK_PIN10, 0) |          \
                                     PIN_AFIO_AF(GPIOK_PIN11, 0) |          \
                                     PIN_AFIO_AF(GPIOK_PIN12, 0) |          \
                                     PIN_AFIO_AF(GPIOK_PIN13, 0) |          \
                                     PIN_AFIO_AF(GPIOK_PIN14, 0) |          \
                                     PIN_AFIO_AF(GPIOK_PIN15, 0))


#if !defined(_FROM_ASM_)
#ifdef __cplusplus
extern "C" {
#endif
  void boardInit(void);
#ifdef __cplusplus
}
#endif
#endif /* _FROM_ASM_ */

#endif /* _BOARD_H_ */
