DL7AD/pecanpico10/tracker/software/source/protocols/packet/aprs.c

/* Certain parts from trackuino copyright (C) 2010  EA5HAV Javi
 *
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
 * You should have received a copy of the GNU General Public License
 * along with this program; if not, write to the Free Software
 * Foundation, Inc., 51 Franklin Street, Fifth Floor, Boston, MA  02110-1301, USA.
 */
#include "config.h"
#include "aprs.h"
#include <stdlib.h>
#include <math.h>
#include <string.h>
#include "debug.h"
#include "base91.h"
#include "digipeater.h"
#include "dedupe.h"
#include "radio.h"
#include "flash.h"
#include "image.h"
#include "beacon.h"
#include "threads.h"

#define METER_TO_FEET(m) (((m)*26876) / 8192)

typedef struct {
	sysinterval_t time;
	char call[AX25_MAX_ADDR_LEN];
} heard_t;


static uint16_t msg_id;
char alias_re[] = "WIDE[4-7]-[1-7]|CITYD";
char wide_re[] = "WIDE[1-7]-[1-7]";
enum preempt_e preempt = PREEMPT_OFF;
static heard_t heard_list[APRS_HEARD_LIST_SIZE];
static bool dedupe_initialized;

const conf_command_t command_list[] = {
	{TYPE_INT,  "pos_pri.active",                sizeof(conf_sram.pos_pri.beacon.active),                     &conf_sram.pos_pri.beacon.active                    },
	{TYPE_TIME, "pos_pri.init_delay",            sizeof(conf_sram.pos_pri.beacon.init_delay),                 &conf_sram.pos_pri.beacon.init_delay                },
	{TYPE_INT,  "pos_pri.sleep_conf.type",       sizeof(conf_sram.pos_pri.beacon.sleep_conf.type),            &conf_sram.pos_pri.beacon.sleep_conf.type           },
	{TYPE_INT,  "pos_pri.sleep_conf.vbat_thres", sizeof(conf_sram.pos_pri.beacon.sleep_conf.vbat_thres),      &conf_sram.pos_pri.beacon.sleep_conf.vbat_thres     },
	{TYPE_INT,  "pos_pri.sleep_conf.vsol_thres", sizeof(conf_sram.pos_pri.beacon.sleep_conf.vsol_thres),      &conf_sram.pos_pri.beacon.sleep_conf.vsol_thres     },
	{TYPE_TIME, "pos_pri.cycle",                 sizeof(conf_sram.pos_pri.beacon.cycle),                      &conf_sram.pos_pri.beacon.cycle                     },
	{TYPE_INT,  "pos_pri.pwr",                   sizeof(conf_sram.pos_pri.radio_conf.pwr),                    &conf_sram.pos_pri.radio_conf.pwr                   },
	{TYPE_INT,  "pos_pri.freq",                  sizeof(conf_sram.pos_pri.radio_conf.freq),                   &conf_sram.pos_pri.radio_conf.freq                  },
    {TYPE_INT,  "pos_pri.mod",                   sizeof(conf_sram.pos_pri.radio_conf.mod),                    &conf_sram.pos_pri.radio_conf.mod                   },
    {TYPE_INT,  "pos_pri.cca",                   sizeof(conf_sram.pos_pri.radio_conf.cca),                    &conf_sram.pos_pri.radio_conf.cca                   },
	{TYPE_STR,  "pos_pri.call",                  sizeof(conf_sram.pos_pri.call),                              &conf_sram.pos_pri.call                             },
	{TYPE_STR,  "pos_pri.path",                  sizeof(conf_sram.pos_pri.path),                              &conf_sram.pos_pri.path                             },
	{TYPE_INT,  "pos_pri.symbol",                sizeof(conf_sram.pos_pri.symbol),                            &conf_sram.pos_pri.symbol                           },
    {TYPE_INT,  "pos_pri.aprs_msg",              sizeof(conf_sram.pos_pri.aprs_msg),                          &conf_sram.pos_pri.aprs_msg                         },

	{TYPE_INT,  "pos_sec.active",                sizeof(conf_sram.pos_sec.beacon.active),                     &conf_sram.pos_sec.beacon.active                    },
	{TYPE_TIME, "pos_sec.init_delay",            sizeof(conf_sram.pos_sec.beacon.init_delay),                 &conf_sram.pos_sec.beacon.init_delay                },
	{TYPE_INT,  "pos_sec.sleep_conf.type",       sizeof(conf_sram.pos_sec.beacon.sleep_conf.type),            &conf_sram.pos_sec.beacon.sleep_conf.type           },
	{TYPE_INT,  "pos_sec.sleep_conf.vbat_thres", sizeof(conf_sram.pos_sec.beacon.sleep_conf.vbat_thres),      &conf_sram.pos_sec.beacon.sleep_conf.vbat_thres     },
	{TYPE_INT,  "pos_sec.sleep_conf.vsol_thres", sizeof(conf_sram.pos_sec.beacon.sleep_conf.vsol_thres),      &conf_sram.pos_sec.beacon.sleep_conf.vsol_thres     },
	{TYPE_TIME, "pos_sec.cycle",                 sizeof(conf_sram.pos_sec.beacon.cycle),                      &conf_sram.pos_sec.beacon.cycle                     },
	{TYPE_INT,  "pos_sec.pwr",                   sizeof(conf_sram.pos_sec.radio_conf.pwr),                    &conf_sram.pos_sec.radio_conf.pwr                   },
	{TYPE_INT,  "pos_sec.freq",                  sizeof(conf_sram.pos_sec.radio_conf.freq),                   &conf_sram.pos_sec.radio_conf.freq                  },
	{TYPE_INT,  "pos_sec.mod",                   sizeof(conf_sram.pos_sec.radio_conf.mod),                    &conf_sram.pos_sec.radio_conf.mod                   },
    {TYPE_INT,  "pos_sec.cca",                   sizeof(conf_sram.pos_sec.radio_conf.cca),                    &conf_sram.pos_sec.radio_conf.cca                   },
	{TYPE_STR,  "pos_sec.call",                  sizeof(conf_sram.pos_sec.call),                              &conf_sram.pos_sec.call                             },
	{TYPE_STR,  "pos_sec.path",                  sizeof(conf_sram.pos_sec.path),                              &conf_sram.pos_sec.path                             },
	{TYPE_INT,  "pos_sec.symbol",                sizeof(conf_sram.pos_sec.symbol),                            &conf_sram.pos_sec.symbol                           },
    {TYPE_INT,  "pos_sec.aprs_msg",              sizeof(conf_sram.pos_sec.aprs_msg),                          &conf_sram.pos_sec.aprs_msg                         },

	{TYPE_INT,  "img_pri.active",                sizeof(conf_sram.img_pri.svc_conf.active),                   &conf_sram.img_pri.svc_conf.active                  },
	{TYPE_TIME, "img_pri.init_delay",            sizeof(conf_sram.img_pri.svc_conf.init_delay),               &conf_sram.img_pri.svc_conf.init_delay              },
	{TYPE_TIME, "img_pri.send_spacing",          sizeof(conf_sram.img_pri.svc_conf.send_spacing),             &conf_sram.img_pri.svc_conf.send_spacing            },
	{TYPE_INT,  "img_pri.sleep_conf.type",       sizeof(conf_sram.img_pri.svc_conf.sleep_conf.type),          &conf_sram.img_pri.svc_conf.sleep_conf.type         },
	{TYPE_INT,  "img_pri.sleep_conf.vbat_thres", sizeof(conf_sram.img_pri.svc_conf.sleep_conf.vbat_thres),    &conf_sram.img_pri.svc_conf.sleep_conf.vbat_thres   },
	{TYPE_INT,  "img_pri.sleep_conf.vsol_thres", sizeof(conf_sram.img_pri.svc_conf.sleep_conf.vsol_thres),    &conf_sram.img_pri.svc_conf.sleep_conf.vsol_thres   },
	{TYPE_TIME, "img_pri.cycle",                 sizeof(conf_sram.img_pri.svc_conf.cycle),                    &conf_sram.img_pri.svc_conf.cycle                   },
	{TYPE_INT,  "img_pri.pwr",                   sizeof(conf_sram.img_pri.radio_conf.pwr),                    &conf_sram.img_pri.radio_conf.pwr                   },
    {TYPE_INT,  "img_pri.freq",                  sizeof(conf_sram.img_pri.radio_conf.freq),                   &conf_sram.img_pri.radio_conf.freq                  },
	{TYPE_INT,  "img_pri.mod",                   sizeof(conf_sram.img_pri.radio_conf.mod),                    &conf_sram.img_pri.radio_conf.mod                   },
    {TYPE_INT,  "img_pri.cca",                   sizeof(conf_sram.img_pri.radio_conf.cca),                    &conf_sram.img_pri.radio_conf.cca                   },
	{TYPE_INT,  "img_pri.speed",                 sizeof(conf_sram.img_pri.radio_conf.speed),                  &conf_sram.img_pri.radio_conf.speed                 },
	{TYPE_INT,  "img_pri.redundantTx",           sizeof(conf_sram.img_pri.redundantTx),                       &conf_sram.img_pri.redundantTx                      },
	{TYPE_STR,  "img_pri.call",                  sizeof(conf_sram.img_pri.call),                              &conf_sram.img_pri.call                             },
	{TYPE_STR,  "img_pri.path",                  sizeof(conf_sram.img_pri.path),                              &conf_sram.img_pri.path                             },
	{TYPE_INT,  "img_pri.res",                   sizeof(conf_sram.img_pri.res),                               &conf_sram.img_pri.res                              },
	{TYPE_INT,  "img_pri.quality",               sizeof(conf_sram.img_pri.quality),                           &conf_sram.img_pri.quality                          },
	{TYPE_INT,  "img_pri.buf_size",              sizeof(conf_sram.img_pri.buf_size),                          &conf_sram.img_pri.buf_size                         },

	{TYPE_INT,  "img_sec.active",                sizeof(conf_sram.img_sec.svc_conf.active),                   &conf_sram.img_sec.svc_conf.active                  },
	{TYPE_TIME, "img_sec.init_delay",            sizeof(conf_sram.img_sec.svc_conf.init_delay),               &conf_sram.img_sec.svc_conf.init_delay              },
	{TYPE_TIME, "img_sec.send_spacing",          sizeof(conf_sram.img_sec.svc_conf.send_spacing),             &conf_sram.img_sec.svc_conf.send_spacing            },
	{TYPE_INT,  "img_sec.sleep_conf.type",       sizeof(conf_sram.img_sec.svc_conf.sleep_conf.type),          &conf_sram.img_sec.svc_conf.sleep_conf.type         },
	{TYPE_INT,  "img_sec.sleep_conf.vbat_thres", sizeof(conf_sram.img_sec.svc_conf.sleep_conf.vbat_thres),    &conf_sram.img_sec.svc_conf.sleep_conf.vbat_thres   },
	{TYPE_INT,  "img_sec.sleep_conf.vsol_thres", sizeof(conf_sram.img_sec.svc_conf.sleep_conf.vsol_thres),    &conf_sram.img_sec.svc_conf.sleep_conf.vsol_thres   },
	{TYPE_TIME, "img_sec.cycle",                 sizeof(conf_sram.img_sec.svc_conf.cycle),                    &conf_sram.img_sec.svc_conf.cycle                   },
	{TYPE_INT,  "img_sec.pwr",                   sizeof(conf_sram.img_sec.radio_conf.pwr),                    &conf_sram.img_sec.radio_conf.pwr                   },
	{TYPE_INT,  "img_sec.freq",                  sizeof(conf_sram.img_sec.radio_conf.freq),                   &conf_sram.img_sec.radio_conf.freq                  },
	{TYPE_INT,  "img_sec.mod",                   sizeof(conf_sram.img_sec.radio_conf.mod),                    &conf_sram.img_sec.radio_conf.mod                   },
    {TYPE_INT,  "img_sec.cca",                   sizeof(conf_sram.img_sec.radio_conf.cca),                    &conf_sram.img_sec.radio_conf.cca                   },
	{TYPE_INT,  "img_sec.speed",                 sizeof(conf_sram.img_sec.radio_conf.speed),                  &conf_sram.img_sec.radio_conf.speed                 },
	{TYPE_INT,  "img_sec.redundantTx",           sizeof(conf_sram.img_sec.redundantTx),                       &conf_sram.img_sec.redundantTx                      },
	{TYPE_STR,  "img_sec.call",                  sizeof(conf_sram.img_sec.call),                              &conf_sram.img_sec.call                             },
	{TYPE_STR,  "img_sec.path",                  sizeof(conf_sram.img_sec.path),                              &conf_sram.img_sec.path                             },
	{TYPE_INT,  "img_sec.res",                   sizeof(conf_sram.img_sec.res),                               &conf_sram.img_sec.res                              },
	{TYPE_INT,  "img_sec.quality",               sizeof(conf_sram.img_sec.quality),                           &conf_sram.img_sec.quality                          },
	{TYPE_INT,  "img_sec.buf_size",              sizeof(conf_sram.img_sec.buf_size),                          &conf_sram.img_sec.buf_size                         },

	{TYPE_INT,  "log.active",                    sizeof(conf_sram.log.svc_conf.active),                       &conf_sram.log.svc_conf.active                      },
	{TYPE_TIME, "log.init_delay",                sizeof(conf_sram.log.svc_conf.init_delay),                   &conf_sram.log.svc_conf.init_delay                  },
	{TYPE_TIME, "log.send_spacing",              sizeof(conf_sram.log.svc_conf.send_spacing),                 &conf_sram.log.svc_conf.send_spacing                },
	{TYPE_INT,  "log.sleep_conf.type",           sizeof(conf_sram.log.svc_conf.sleep_conf.type),              &conf_sram.log.svc_conf.sleep_conf.type             },
	{TYPE_INT,  "log.sleep_conf.vbat_thres",     sizeof(conf_sram.log.svc_conf.sleep_conf.vbat_thres),        &conf_sram.log.svc_conf.sleep_conf.vbat_thres       },
	{TYPE_INT,  "log.sleep_conf.vsol_thres",     sizeof(conf_sram.log.svc_conf.sleep_conf.vsol_thres),        &conf_sram.log.svc_conf.sleep_conf.vsol_thres       },
	{TYPE_TIME, "log.cycle",                     sizeof(conf_sram.log.svc_conf.cycle),                        &conf_sram.log.svc_conf.cycle                       },
	{TYPE_INT,  "log.pwr",                       sizeof(conf_sram.log.radio_conf.pwr),                        &conf_sram.log.radio_conf.pwr                       },
	{TYPE_INT,  "log.freq",                      sizeof(conf_sram.log.radio_conf.freq),                       &conf_sram.log.radio_conf.freq                      },
	{TYPE_INT,  "log.mod",                       sizeof(conf_sram.log.radio_conf.mod),                        &conf_sram.log.radio_conf.mod                       },
    {TYPE_INT,  "log.cca",                       sizeof(conf_sram.log.radio_conf.cca),                        &conf_sram.log.radio_conf.cca                       },
	{TYPE_INT,  "log.speed",                     sizeof(conf_sram.log.radio_conf.speed),                      &conf_sram.log.radio_conf.speed                     },
	{TYPE_STR,  "log.call",                      sizeof(conf_sram.log.call),                                  &conf_sram.log.call                                 },
	{TYPE_STR,  "log.path",                      sizeof(conf_sram.log.path),                                  &conf_sram.log.path                                 },
	{TYPE_INT,  "log.density",                   sizeof(conf_sram.log.density),                               &conf_sram.log.density                              },

	{TYPE_INT,  "aprs.rx.active",                sizeof(conf_sram.aprs.rx.svc_conf.active),                   &conf_sram.aprs.rx.svc_conf.active                  },
	{TYPE_TIME, "aprs.rx.init_delay",            sizeof(conf_sram.aprs.rx.svc_conf.init_delay),               &conf_sram.aprs.rx.svc_conf.init_delay              },

	{TYPE_INT,  "aprs.rx.freq",                  sizeof(conf_sram.aprs.rx.radio_conf.freq),                   &conf_sram.aprs.rx.radio_conf.freq                  },
	{TYPE_INT,  "aprs.rx.mod",                   sizeof(conf_sram.aprs.rx.radio_conf.mod),                    &conf_sram.aprs.rx.radio_conf.mod                   },
	{TYPE_INT,  "aprs.rx.speed",                 sizeof(conf_sram.aprs.rx.radio_conf.speed),                  &conf_sram.aprs.rx.radio_conf.speed                 },
    {TYPE_STR,  "aprs.rx.call",                  sizeof(conf_sram.aprs.rx.call),                              &conf_sram.aprs.rx.call                             },
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
