DL7AD/pecanpico10/(commit log)

2018-01-15 Initial tracker firmware commit
    [stm_spc56ec74a256s_spc56ec74_minimodule_debug_jtag.cfg, stm_xpc560b64_minimodule_debug_jtag.cfg, stm_xpc560b_spc560d40_minimodule_debug_jtag.cfg, stm_xpc560p_minimodule_40mhz_debug_jtag.cfg, stm_xpc563m64_minimodule_debug_jtag.cfg, stm_xpc564a_spc564a70_minimodule_debug_jtag.cfg, stm_xpc56el_minimodule_lockstep_debug_jtag.cfg]
2018-01-16 Fixed GPS startup error (GPS didnt start on first cycle) Attempt to fix SD card error (not working yet) Tidied up code
    [config.c, debug.c, main.c, sd.c, threads.c, tracking.c]
2018-01-20 Updated time driver, removed ChibiOS from repro
    [stm_spc56ec74a256s_spc56ec74_minimodule_debug_jtag.cfg, stm_xpc560b64_minimodule_debug_jtag.cfg, stm_xpc560b_spc560d40_minimodule_debug_jtag.cfg, stm_xpc560p_minimodule_40mhz_debug_jtag.cfg, stm_xpc563m64_minimodule_debug_jtag.cfg, stm_xpc564a_spc564a70_minimodule_debug_jtag.cfg, stm_xpc56el_minimodule_lockstep_debug_jtag.cfg]
2018-01-21 Added upgraded ChibiOS to Repro
    [stm_spc56ec74a256s_spc56ec74_minimodule_debug_jtag.cfg, stm_xpc560b64_minimodule_debug_jtag.cfg, stm_xpc560b_spc560d40_minimodule_debug_jtag.cfg, stm_xpc560p_minimodule_40mhz_debug_jtag.cfg, stm_xpc563m64_minimodule_debug_jtag.cfg, stm_xpc564a_spc564a70_minimodule_debug_jtag.cfg, stm_xpc56el_minimodule_lockstep_debug_jtag.cfg]
2018-01-21 Fixed board.c PAL configuration, test settings in makefile and Vector9c disable for PAL EXTI in mcuconf.h
    [board.c, mcuconf.h, sleep.h]
2018-01-23 Added CMSIS DSP, added decoder, setup halconf.h & mcuconf.h, updated makefile, reduced LED usage to single LED. Ready for test code to be added.
2018-01-24 Implemented receiver test at console, fixed radio configuration
    [debug.c, threads.c]
2018-01-25 Attemps to make receiver work (not working yet)
    [chconf.h, config.c, mcuconf.h]
2018-01-28 Found low RX sensitivity error Removed old APRS library Updated APRS decoding libraries Implemented squelch before transmission with 3sec timeout Now RX and TX can be used concurrently
    [aprs.c, aprs.h, ax25_pad.c, config.c, corr_q31.c, corr_q31.h, dbguart.c, dbguart.h]
2018-01-30 Added ?APRSP, ?GPIO and ?RESET queries Reorganized APRS messaging Updated APRS demodulation library
    [aprs.c, aprs.h, ax25_dump.c, ax25_dump.h, config.c, corr_q31.c, corr_q31.h, dbguart.c]
2018-02-08 Change systick to 5KHz. BPF to 55, enable mag filter and set to 15
2018-02-08 Fixed tracking manager startup
    [threads.c, types.h]
2018-02-08 Fixed cycle time error, fixed symbol encoding error
    [aprs.c, aprs.h, config.c, position.c, sleep.c, types.h]
2018-02-08 Moved APRS related stuff out of Si446x driver
2018-02-08 Fixed error in Si446x driver
    [si446x.c, threads.c]
2018-02-08 Interim update. 446x work in progress. RX not working.
    [ax25_dump.c, ax25_dump.h, ax25_pad.h, config.c, pktconf.h, portab.h, rxafsk.c]
2018-02-08 Changed board configuration, Si446x shutdown error
    [board.h]
2018-02-09 Implemented PAL interrupt driver for VSYNC interrupt
2018-02-11 Fixed image sampling (stage 1, working, not finished yet)
    [config.c, mcuconf.h, ov5640.c, si446x.c]
2018-02-11 Fixed packet spacing error
    [config.c, image.c]
2018-02-12 Fixed camera lockup errors added si446x-feeder timeout exception Removed UART5 from mcuconf
    [config.c, image.c, mcuconf.h, ov5640.c, pac1720.c, pi2c.c, si446x.c]
2018-02-17 Increased log memory capacity Moved configuration settings to certain flash sector
2018-02-24 Removed XAL from LPS coil
    [pecanpico10.sch]
2018-03-01 Remove threadwait change.
2018-03-01 Move serial debug init into main. Restore TRACE outputs in 446x.c
2018-03-02 Minor formatting fix to debug messages.
    [si446x.c]
2018-03-02 Expand encoding selectors in radio manager. Revise SPI in 446x.c
2018-03-02 Change to not pass invalid frames to RX packet callback.
2018-03-03 Brought SD card to work
    [mkfs.xls]
2018-03-03 Abort packet TX when 446x transmit start fails.
    [si446x.c]
2018-03-03 Additional documentation, more work on 446x driver.
2018-03-04 Fixed WTEXIT bug in main, fixed crash bug on exit command
    [main.c]
2018-03-04 Modified component values, created BOM
    [pecanpico10.kicad_pcb, pecanpico10.sch, pecanpico10_bom.csv]
2018-03-05 Reduce size of RX packet payload to 512 limit. Rework 446x getState.
    [config.c, pktservice.h, rxax25.h, si446x.c, txhdlc.c, txhdlc.h]
2018-03-06 Fix RSSI setting bug. Add save indicator MAGIC to config save.
    [aprs.c, config.c, pktradio.c, pktservice.c, si446x.c, si446x.h]
2018-03-07 Add conditional to select I2C TX/RX pins on connector
2018-03-08 Improved error handling in packet services.
    [aprs.c, main.c, pktradio.c, pktradio.h, pktservice.c, pktservice.h, portab.h, si446x.c]
2018-03-09 Quick fix for 446x.c temperature reading. Refactoring opportunity.
    [config.c, pktservice.c, si446x.c]
2018-03-09 Rework 446x.c get temperature. Fix I2C #define and debug clash.
    [config.h, portab.c, si446x.c, si446x.h]
2018-03-09 Fix lockup when using I2C external and pkt dump to USART3 enabled.
    [config.c, si446x.c]
2018-03-10 Fix GPS Poll seconds value. Add frequency_setting.txt document.
    [config.c, si446x.c, types.h, ublox.c]
2018-03-10 Fixed no SD card connected error
    [board.h, image.c, sd.c]
2018-03-11 Rework radio manager locking/startup of radio. Bug still in afks_feeder
    [config.c, image.c, ov5640.c, ov5640.h, pktconf.h, pktradio.c, pktservice.c]
2018-03-11 Created 10b hardware files
    [pecanpico10-B.Cu.gbl, pecanpico10-B.Mask.gbs, pecanpico10-B.Paste.gbp, pecanpico10-B.SilkS.gbo, pecanpico10-Edge.Cuts.gm1, pecanpico10-F.Cu.gtl, pecanpico10-F.Mask.gts, pecanpico10-F.Paste.gtp]
2018-03-12 Fix AFSK feeder thread FIFO counting error.
    [si446x.c]
2018-03-13 Revise packet thread to dynamic. Addition diagnostics.
2018-03-13 Added I2C clock stretching timeout
2018-03-14 Rework to support test project build.
    [pktconf.h, pktradio.c, pktradio.h, pktservice.h, portab.h, rxafsk.c, rxax25.h, rxpwm.c]
2018-03-16 Restructured USB, increased camera clock
2018-03-21 Fix USB shell crash. TX iterator WIP. Minor changes in pkt and radio.
    [main.c, pktservice.h, rxhdlc.h, si446x.c, txhdlc.c, txhdlc.h, usb.c]
2018-03-21 Fixed minor compilation error
    [pktconf.h]
2018-03-22 Added trace level
2018-03-24 Add -D default for trace level. Trace command w/o param lists level.
2018-03-26 Resolve event ID conflicts in main thread. WIP FSK TX.
    [pktconf.h, pktradio.c, pktservice.c, pktservice.h, si446x.c, si446x.h, usb.c]
2018-03-29 Refactor pkt functions. More dynamic TX threads. Fix 2FSK/AFSK TX clash.
    [aprs.c, ax25_pad.c, ax25_pad.h, image.c, ov5640.c, pktconf.h, pktradio.c, pktradio.h]
2018-03-29 Fix error in sense of packet open. Tidy up in 446x driver.
    [aprs.c, ax25_pad.c, commands.c, config.c, image.c, pktradio.c, pktservice.c]
2018-03-30 Improve error checking for packet buffers. Improve 446x driver.
    [config.c, image.c, pktevt.c, position.c, si446x.c, si446x.h]
2018-03-30 Further handling of out of packet buffers condition in image thread.
2018-03-30 Fix I2C interfering with image capture (was not locked).
    [config.c, mcuconf.h, ov5640.c, pi2c.c, ublox.c]
2018-04-05 Fix memory leak in TX. Add 'heap' command. Minor refactoring & docs.
    [aprs.c, ax25_pad.c, ax25_pad.h, commands.c, commands.h, config.c, pktconf.h, pktservice.c]
2018-04-06 Implement burst mode packet send for 9600. Improved error messages.
    [aprs.c, ax25_pad.c, ax25_pad.h, collector.c, config.c, image.c, main.c, ov5640.c]
2018-04-07 Fix memory leak in image.c + remove redundant functions in pktservice.c
    [ax25_pad.c, commands.c, config.c, image.c, mcuconf.h, pktconf.h, pktradio.c, pktradio.h]
2018-04-07 Fix memory leak in TransmitOnRadio
    [debug.h, image.c, pktconf.h, pktradio.c, si446x.c, usb.c, usb.h]
2018-04-07 Revert CCM heap to normal. Speed up burst send TX. Increase exc. stack.
    [ax25_pad.c, commands.c, config.c, image.c, main.c, ov5640.c, pktconf.c, pktservice.c]
2018-04-08 Fix send_spacing in IMG. Minor comment updates.
    [aprs.c, config.c, image.c, pktradio.c, si446x.c]
2018-04-09 Fixed camera memory clear bug. Various fixes. Add CRC calc to UBLOX.
    [aprs.c, ax25_pad.c, ax25_pad.h, collector.c, config.c, config.h, debug.h, image.c]
2018-04-12 Multiple updates. Primarily image capture. SD card currently disabled.
2018-04-13 Fix buffer overrun in ax25. Chibios update. Stop decoder during TX.
    [aprs.c, ax25_pad.c, ax25_pad.h, chconf.h, collector.c, config.c, halconf.h, main.c]
2018-04-14 Rework IO config. Reinstate SD card (untested).
    [aprs.c, board.c, board.h, config.c, image.c, main.c, ov5640.c, pi2c.c]
2018-04-15 Switched from SQLite to MariaDB
2018-04-16 Fixed USB/battery isolation bug, increased schottky diode pad size
    [pecanpico10-B.Cu.gbl, pecanpico10-B.Mask.gbs, pecanpico10-B.Paste.gbp, pecanpico10-B.SilkS.gbo, pecanpico10-Edge.Cuts.gm1, pecanpico10-F.Cu.gtl, pecanpico10-F.Mask.gts, pecanpico10-F.Paste.gtp]
2018-04-16 Fixed primary keys in position table
    [decoder.py]
2018-04-17 Added one more pin to pinheader
    [pecanpico10.kicad_pcb, pecanpico10.sch]
2018-04-17 Relabeled pinheader
    [pecanpico10.kicad_pcb, pecanpico10.sch]
2018-04-17 Moved LPF a bit backward
    [pecanpico10.kicad_pcb]
2018-04-17 Multiple changes.
    - Implement parser for embedded APRS message commands.
    - Update board definitions.
    - Only lock USB for radio id USB active.
    - Blue LED blinks on packet decode or fast blinks if paused.
    - Revise ublox CSUM implementation.
    - Minor TRACE text changes.
2018-04-17 Small fix to ?aprsh command.
    [aprs.c, config.c, rxafsk.c]
2018-04-17 Fix ?aprsd command output when there are no DIRECTS.
    [aprs.c]
2018-04-18 Fixed autoreload bug at image webpage, fixed timerange bug
2018-04-19 Multiple updates
    - Trace out and shell. To get shell type any key. Trace is suspended.
    - Fixed bug where AX25 receive FIFO was left locked.
    - Improved trace message for AX25 packets with bad CRC.
    - Additions to config.c in preparation for adding fixed location beacon.
    [aprs.c, aprs.h, ax25_pad.c, ax25_pad.h, collector.c, config.c, config.h, image.c]
2018-04-19 Fixed power measuring bug
    [pecanpico10.kicad_pcb, pecanpico10.sch]
2018-04-19 Tidy up
    [pecanpico10.kicad_pcb]
2018-04-20 Fix POS APRSD message call sign and a few other minor edits.
    [config.c, portab.c, position.c, types.h, usb.c]
2018-04-21 Implement fixed location for APRS DIGI.
    - Add BCN thread to beacon location.
    - New GPS ENUM state of GPS_FIXED.
    - Deprecate test_gps hack.
    - Rework APRSD src>dest & recipient config.
    [aprs.c, aprs.h, chconf.h, collector.c, collector.h, commands.c]
2018-04-21 Fix destination address in APRS message.
    [aprs.c]
2018-04-26 Multiple changes...
    - Digipeater beacon can now use fixed coordinates only (no GPS)
    - Adopt more tyedefs in types.h
    - WIP for using scan where geofence is inoperable
    [aprs.c, aprs.h, board.h, collector.c, collector.h, config.c]
2018-04-27 Multiple changes.
    - Update APRS position packet to include timestamp.
    - Add ability to set air pressure level to control GPS airborne mode
    - Add capability for time only acquisition from GPS when fixed coord set
    - Revise GPIO naming to use IO1 - IO3 (2 & only if not external BME)
    [aprs.c, aprs.h, ax25_pad.c, ax25_pad.h, board.h, collector.c, collector.h]
2018-04-27 Check BMEi1 is OK when using air pressure to control GPS airborne mode
2018-04-29 Fix telemetry config incorrect addressing.
    [aprs.c, collector.c, position.c]
2018-04-29 Added 2m bandpass trap filter in GPS rx Removed unnecessary resistor Edited/Added schematic comments
    [pecanpico10-B.Cu.gbl, pecanpico10-B.Mask.gbs, pecanpico10-B.Paste.gbp, pecanpico10-B.SilkS.gbo, pecanpico10-Edge.Cuts.gm1, pecanpico10-F.Cu.gtl, pecanpico10-F.Mask.gts, pecanpico10-F.Paste.gtp]
2018-04-29 Update port naming in board.h. Fix collector loop inclusion.
    [board.h, collector.c, collector.h, portab.c]
2018-04-30 Partial implementation of multi-board build system.
    - All pp sources except main.c now in source folder
    - Still to implement autobuild to simplify make files
    [mkfs.xls]
2018-04-30 Added SAW Filter Optimized Antenna connections Created SAW Filter pad
    [pecanpico10.kicad_pcb, pecanpico10.sch]
2018-05-01 Completed multi-build framework.
    - Make files now uses autobuild of all sources in source folder
    - Revised makefiles to use project name for portability setting
2018-05-02 Moved wires around, added vias, created GERBERs for 10b
    [pecanpico10-B.Cu.gbl, pecanpico10-B.Mask.gbs, pecanpico10-B.Paste.gbp, pecanpico10-B.SilkS.gbo, pecanpico10-Edge.Cuts.gm1, pecanpico10-F.Cu.gtl, pecanpico10-F.Mask.gts, pecanpico10-F.Paste.gtp]
2018-05-02 Refactor GPS altitude model switching...
2018-05-03 Fix CMSIS library path name case. Minor text changes in ublox.c
    [config.c, ublox.c]
2018-05-04 Renamed power nets, added comments to schematic, exported schematic and 3D pictures to PDF
    [pecanpico10.kicad_pcb, pecanpico10.sch]
2018-05-09 Revert to normal CK48 PLL source.
    [config.c, mcuconf.h]
2018-05-13 Fix POS thread TX frequency and identity.
    [pktradio.c, position.c]
2018-05-13 Change callsign in BCN Directs. Filter "Directs" from APRS CMDs.
2018-05-13 Add to TRACE info for POS, BCN and IMG telling which call and freq.
2018-05-13 Fix incorrect frequency for blind send after change of frequency.
    [si446x.c]
2018-05-13 Revised frequency description text in BCN, POS, IMG trace.
2018-05-13 Fix formatting of "sats" command output.
    [commands.c]
2018-05-14 Reworked some USB code and settings that may help SDU thread stall.
    [halconf.h, portab.c, usb.c, usb.h]
2018-05-14 Improve APRS trace messages. Fix BCN not reporting from LOG pos'n.
    [aprs.c, config.c, halconf.h]
2018-05-21 Include openocd config into cfg folder. Update gitignore.
    [pp10_openocd.cfg]
2018-05-25 Several changes...
    - Revise naming of decoder pause/resume functions
    - Add #defines for PWM in-band codes
    - Fix bug where PWM queue write did not handle end of buffer
    [ov5640.c, pktconf.h, pktevt.c, pktradio.c, pktradio.h, rxafsk.c, rxpwm.c, rxpwm.h]
2018-05-25 Rationalise GPIO LED configuration.
2018-05-28 Minor rework of PWM buffer full handling.
    [rxpwm.c, rxpwm.h]
2018-06-08 Work in progress...
    - Enable make for PP10b
    - Update PP10b board.h and portab
    - Some work on moving POS -> BCN to merge them
2018-06-12 Implemented CTS request timeout (Si446x) added error list
    [commands.c, commands.h, debug.c, debug.h, si446x.c]
2018-06-12 WIP of PWM buffer management to reduce memory footprint
    - Implement buffer chaining
    - Enable PWM buffers to be moved into CCM
2018-06-13 Revise APRS IO bits handling. Changes supporting rev B complete.
    - IO1 to IO4 now reported in telemetry regardless of board rev.
    - IO1 to IO4 accepted in APRS command but no effect if not configured.
2018-06-13 Implementation of fragmented PWM buffering.
    - Enabled on PP10A build only for now.
    - Uses memory pool in CCM.
2018-06-14 Work in progress
    - Refactor AFSK decoder state machine in rxafsk.c
    - Additional work on revised PWM buffering (not enabled yet)
    - Fix trace info message for GPIO in collector.c
    [collector.c, pktconf.h, portab.h, rxafsk.c, rxafsk.h, rxpwm.c, rxpwm.h]
2018-06-15 Updated PWM buffering release.
    - Enabled for PP10A using CCM based buffers.
2018-06-15 Fix to AFSK decoder.
    - drop packets not closed correctly with HDLC flag.
    - handle decoder shutdown better.
    [rxafsk.c]
2018-06-19 Changes:
    - Rework GPS datapoint fallback when GPS not operational
    - Update ChibiOS to rev 12114. Remove unreferenced folders.
    [stm_spc56ec74a256s_spc56ec74_minimodule_debug_jtag.cfg, stm_xpc560b64_minimodule_debug_jtag.cfg, stm_xpc560b_spc560d40_minimodule_debug_jtag.cfg, stm_xpc560p_minimodule_40mhz_debug_jtag.cfg, stm_xpc563m64_minimodule_debug_jtag.cfg, stm_xpc564a_spc564a70_minimodule_debug_jtag.cfg, stm_xpc56el_minimodule_lockstep_debug_jtag.cfg]
2018-06-21 Work in progress (note: POS may not be functional in this rev)
    - Revise config.c structure to move items out to global level
    - Rework collector to be service style thread
    - Reworking beacon.c to become telem service for both DIGI and POS
    [aprs.c, chconf.h, collector.c, collector.h, config.c, image.c]
2018-06-23 Implement independent fitted/not fitted for BMEe1 & BMEe2
    [bme280.c, collector.c, collector.h]
2018-06-23 Fix time stamp for fixed GPS.
    [collector.c, pflash.c]
2018-06-23 Revise BME280 addressing (swap E1 & E2 ICU) + minor changes
    [aprs.c, bme280.c, collector.c, collector.h, pktservice.c]
2018-06-26 Changes...
    - Implement ?aprsp so that it runs a one time beacon thread
    - Enable ?aprsp to respond from the profile of the rx call sign
2018-06-26 Bypass startup delay for one time beacon thread run.
2018-06-26 Changes:
    - Minor rework of ?aprsp handling (more to be done)
    - Enable PAC1720 update thread
    - Start implementation of generic thread terminator
    [aprs.c, aprs.h, config.c, pac1720.c, portab.c, threads.c, threads.h]
2018-06-28 Fixed GPS UART implementation
    [ublox.c, ublox.h]
2018-06-28 Updates...
    - Minor fix to ?aprsd command.
    - Changes to beacon.c to accomodate chnage in ?aprsd.
    - Add thread terminator capability to idle thread.
    - More tidy up in portab files.
    [aprs.c, chconf.h, portab.h, threads.c, threads.h]
2018-06-28 Reset invalid sat info when using FIXED location.
    [collector.c]
2018-06-28 Improve handling of low battery and init error condition for GPS.
    [aprs.c, collector.c, collector.h, ublox.c, ublox.h]
2018-06-28 Fix error introduced when reworking GPS I2C/UART configuration
    [config.c, main.c, ublox.c]
2018-06-29 Fix assert due to RX packet buffer addressing error.
    [aprs.c, config.c, rxafsk.c]
2018-07-01 Added new power scheme
2018-07-01 Fixed decoder loop bug
    [decoder.py]
2018-07-01 Multiple updates:
    - Revise and simplify AFSK state machine
    - Make ?aprsp OTA command non-blocking in command processor
    - Implement thread cleanup daemon in idle thread
    - Implement thread termination for rx packet callback threads
    - Implement thread termination for APRSP beacon thread
2018-07-02 Additional changes to reduce core memory footprint...
    - Reduce thread WA sizes for beacon and collector
    - Move beacon WA to CCM
    - Move AFSK decoder WA into CCM
    - Fix APRS PARAM list string sizes
    [aprs.c, collector.c, pktconf.h, pktradio.c, pktservice.c, portab.h]
2018-07-04 Made website design adjustments, fixed loop bug (unfinished)
    [decoder.py]
2018-07-04 Multiple changes:
    - WIP LLD functions for abstraction of radio interfaces
    - Add new string output functions for GPS states and model
    - Trim WA size for image thread
    - Further tidy up in AFSK decoder
2018-07-08 Move all GPIO definitions in portab.h
    [pp10_openocd.cfg]
2018-07-10 Changes:
    - Move GPIO definitions from board.h into portab.h
    - Add time command to CLI
    - WIP rework of beacon framework
    [board.h, collector.c, commands.c, commands.h, config.c, debug.h, main.c]
2018-07-11 Rework debug UART configuration. Move si446x driver to drivers folder.
    [ax25_dump.c, commands.c, config.c, dbguart.c, main.c, pktconf.c, pktevt.c, portab.c]
2018-07-12 Fix EI2C for 10B board. Enable debug UART. Handle ICU zer0.
    [collector.c, dbguart.c, dbguart.h, ei2c.c, portab.h, rxafsk.c, rxafsk.h, rxpwm.c]
2018-07-15 Refactor UART debug outputs. Fix USB event handler.
    [corr_q31.c, dbguart.c, pktconf.h, portab.c, portab.h, rxafsk.c, rxafsk.h, rxpwm.c]
2018-07-17 Multiple changes:
    - Rework packet system event codes
    - Revise radio manager to support pending changes to 446x driver
    - Minor updates to documentation
    - WIP update 446x driver to dynamically configure 4464/4463 chip
    [config.c, debug.c, debug.h, main.c, ov5640.c, pktconf.h, pktevt.c, pktradio.c]
2018-07-17 Temporary fix to overcome syscalls.c link error
    [main.c]
2018-07-17 Interim fix for rev B boards built with si4463 suffering poor RX
    - Boards with 4463 require an Si patch and changes to register init
    - This interim fix uses a #define in portab.h to switch setup
    - Dynamic configuration by chip detection will be implemented soon
    [config.c, pktradio.c, portab.h, rxafsk.h, si446x.c, si446x.h]
2018-07-21 Implement dynamic Si446x chip identification.
    - Patch is applied if 4463 detected
    - Register settings differ if 4463 detected
    - Added 'radio' command in CLI to list radio data
    - Patches to ChibiOS (also in trunk)
    - Update of SPI settings halconf.h to match latest ChibiOS
    - Move assert for invalid radio in common function
2018-07-31 WIP update of 446x driver and portab support of multi-radio
2018-07-31 Multi-radio capability implemented in 446x driver.
2018-08-04 Multiple changes...
    - More work on radio HAL/LLD
    - Geofence and default frequency rework
    - Fix 446x exception halt on TX timeout
    - Further rework of portab files
    [config.c, ov5640.c, pktconf.h, pktradio.c, pktradio.h, pkttypes.h, portab.c]
2018-08-05 Fix off frequency transmit. Multiple updates to radio HAL.
    [image.c, ov5640.c, pktradio.c, pktradio.h, pktservice.c, pkttypes.h, portab.h]
2018-08-06 Changes:
    - GPS power switch off when detecting low volts.
    - Update "no camera" image.
    - Add thread sleep in image capture retry sequence.
2018-08-06 Clear aged GPS data if GPS not started due low volts.
2018-08-07 Radio driver changes:
    - moving 446x.c register settings from common to RX function.
    - adjust RSSI thresholds separately for 4463 versus 4464.
2018-08-08 Updates:
    - Set config.c example of using POS for DIGI beacon
    - Collector waits 60S max for GPS fix before giving result
    - New datapoint with state GPS_TIME is written when RTC is first set
    [collector.c, collector.h, config.c, si446x.c]
2018-08-10 Changes:
    - Deprecate EXTI from mcuconf.h
    - Move setting out of pktconf.c and deprecate it
    - New status codes and diagnostics added to AFSK decoder
    - Revise allocation packet service and AFSK driver structures
    - Revise 446x conditional initialisation placement
2018-08-12 Switch "no camera" image to interlaced. SSDV can't handle progressive.
2018-08-15 Reimplemented debug on UART again
2018-08-15 Fixed va bug, still broken
    [debug.c]
2018-08-18 Added more performance to image insertion
